barrymulinwqn/ESP32-robot-competition/Arduino/TB6612_D153C_opposite.jpg

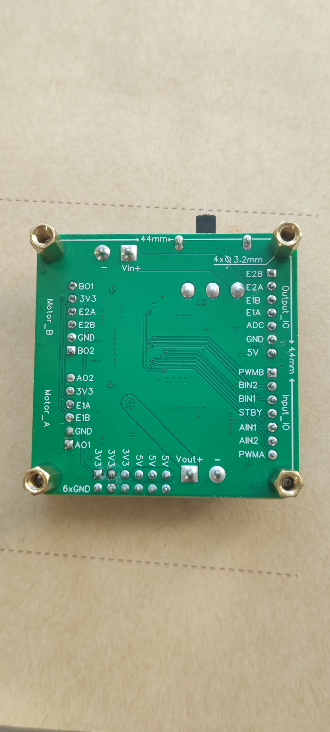
Arduino/TB6612_D153C_opposite.jpg
