barrymulinwqn/ESP32-robot-competition/Arduino/joystick_bluetooth/2M16S_final.jpg

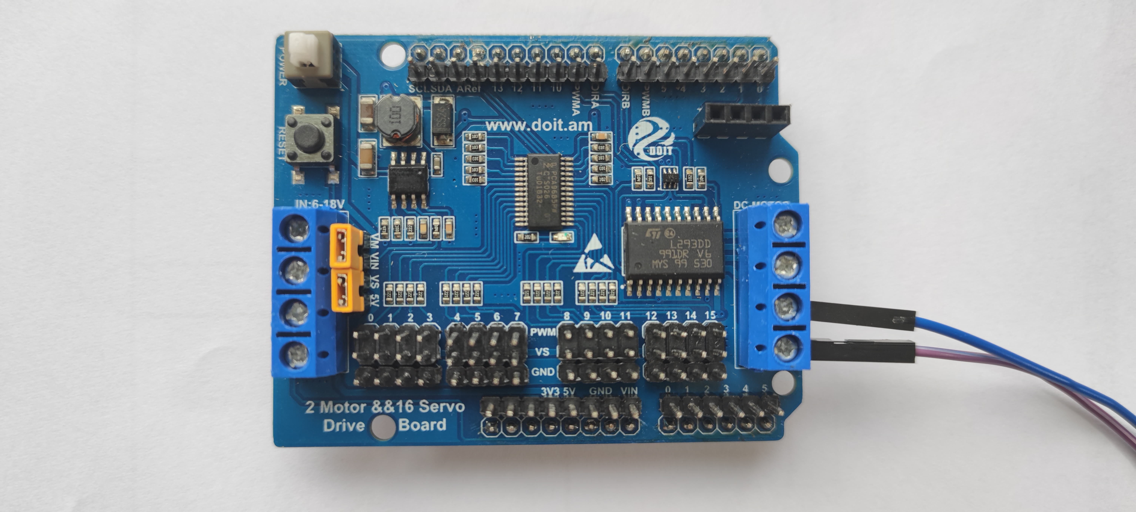
Arduino/joystick_bluetooth/2M16S_final.jpg
