barrymulinwqn/ESP32-robot-competition/README.md

# ESP32-robot-competition
ESP32 Arduino Android
