barrymulinwqn/ESP32-robot-competition/Arduino/硬件接线图.md

# 硬件接线图

## 硬件清单

| 设备 | 型号 | 数量 |
|---|---|---|
| 主控芯片 | ESP32-S3 N8R2 开发板 | 1 |
| 电机驱动模块 | TB6612 D153C 双路驱动稳压模块 | 1 |
| 电池 | 18650 锂离子电池 7.4V 5550mWh | 2节（串联） |
| 直流电机 | 33GB-520-18.7F DC 12V 320RPM | 2 |
| 激光发射器 | 18×45 980nm 30mW 100KHz 5V TTL调制 | 1 |
| 激光接收器 | VS1838B（1838） | 1 |
| 安卓手机 | - | 1 |

---

## 1. 供电电路

> ⚠️ **D153C 与普通 TB6612 裸板不同**：D153C 是**内置降压稳压电路的增强版模块**，
> 自带 ON/OFF 开关，直接将电池电压转换为 5V 和 3.3V 向外输出，无需额外降压模块。

```
18650 电池组（2节串联 标称~7.4V，满电~8.4V）
        │
        ├──[正极]──────────────→ D153C 顶部端子 Vin+（电源输入正极）
        │                               │
        │                    内置 ON/OFF 开关
        │                               │
        │                    D153C 内置降压稳压电路
        │                       ├── 5V 输出 ──→ ESP32-S3 5V 引脚
        │                       ├── 5V 输出 ──→ 激光发射器 VCC
        │                       ├── 3V3 输出 ──→ VS1838B VCC
        │                       └── Vout+ ──→ 电池原始电压直通（备用）
        │
        └──[负极]──────────────→ D153C 顶部端子 -（共地 GND，接所有模块 GND）
```

> **重要说明**
> - 2节 18650 串联标称 7.4V，电机额定 12V，实际转速约为额定的 62%，扭矩按比例降低，仍可正常工作
> - D153C 模块**内置降压电路**，5V 输出直接为 ESP32-S3 供电，**无需另备 LM2596 等独立降压模块**
> - D153C 模块的 5V/3V3 输出已做噪声隔离，电机启动浪涌不会影响 ESP32 供电稳定性
> - D153C 顶部有 **ON/OFF 拨动开关**，整个系统统一断电

---

## 2. ESP32-S3 N8R2 → TB6612 D153C 接线

### TB6612 D153C 模块引脚布局（实物参考）

```
┌─────────────────────────────────────────────────────────┐
│                 D153C 模块正面（俯视）                    │
│                                                         │
│  ┌─────────────┐  [ON/OFF 拨动开关]                      │
│  │  -  │ Vin+ │  ← 顶部 2针螺丝端子（电池输入）          │
│  └─────────────┘                                        │
│                                                         │
│  右侧 Input IO（控制信号输入，来自 ESP32）：             │
│    PWMB BIN2 BIN1 STBY AIN1 AIN2 PWMA                  │
│                                                         │
│  右侧 Output IO（编码器/电源输出）：                     │
│    5V  GND  E1B  E1A  E2A  E2B                          │
│                                                         │
│  左侧 Motor_B 输出（通孔引脚）：                        │
│    BO1  3V3  E2A  E2B  GND  BO2                         │
│                                                         │
│  左侧 Motor_A 输出（通孔引脚）：                        │
│    AO2  3V3  E1A  E1B  GND  AO1                         │
│                                                         │
│  底部排针（左→右）：                                    │
│    6xGND | 3V3 | 3V3 | 5V | 5V | 5V | Vout+            │
│                                                         │
│  ┌───────────┐  ┌───────────┐  ← 右侧白色 JST 4Pin      │
│  │ Motor_B   │  │ Motor_A   │    (电机+编码器接口)       │
│  └───────────┘  └───────────┘                           │
└─────────────────────────────────────────────────────────┘
```

> **引脚分区说明**
> - **顶部端子 Vin+/-**：电池电源唯一输入口，接电池后由内置开关控制通断
> - **Input IO**（右侧下组）：来自 ESP32 的控制信号（PWMA/B、AIN/BIN、STBY）
> - **Output IO**（右侧上组）：5V 和 GND 输出，以及编码器信号引出
> - **底部 3V3/5V**：稳压输出，可为 ESP32 和其他模块供电
> - **编码器引脚 E1A/E1B/E2A/E2B**：若电机带编码器则接入，本项目暂不使用可悬空

### 接线对照表

| D153C 引脚 | 方向 | 连接至 | 说明 |
|:---:|:----:|:---:|---|
| **Vin+**（顶部端子） | ← | 电池正极（~7.4V） | 模块唯一电源正极输入，驱动电机 + 内部稳压 |
| **-**（顶部端子） | ← | 电池负极 / 共地 | 模块唯一电源负极输入 |
| **5V**（底部排针） | → | ESP32-S3 **5V** 引脚 | D153C 向外提供 5V，为 ESP32 供电 |
| **3V3**（底部排针） | → | VS1838B VCC / 激光器备用 | D153C 向外提供 3.3V |
| **GND**（底部 6xGND） | — | ESP32 GND / 所有模块共地 | 接任意一个 GND 针即可 |
| **STBY** | ← | GPIO 10 | 驱动使能（HIGH=工作，LOW=休眠）|
| **PWMA** | ← | GPIO 4 | 左电机（A）PWM 速度控制 |
| **AIN1** | ← | GPIO 5 | 左电机（A）方向控制引脚1 |
| **AIN2** | ← | GPIO 6 | 左电机（A）方向控制引脚2 |
| **PWMB** | ← | GPIO 7 | 右电机（B）PWM 速度控制 |
| **BIN1** | ← | GPIO 8 | 右电机（B）方向控制引脚1 |
| **BIN2** | ← | GPIO 9 | 右电机（B）方向控制引脚2 |

---

## 3. TB6612 D153C → 电机（33GB-520-18.7F）接线

| TB6612 引脚 | 连接至 | 说明 |
|:---:|:---:|---|
| **AO1** | → 左电机 正极线（红） | 电机 A 输出端1 |
| **AO2** | → 左电机 负极线（黑） | 电机 A 输出端2 |
| **BO1** | → 右电机 正极线（红） | 电机 B 输出端1 |
| **BO2** | → 右电机 负极线（黑） | 电机 B 输出端2 |

> 若调试时电机实际转向与预期相反，**互换该电机的两根输出线**即可（例如 AO1/AO2 对调），无需修改代码。

---

## 4. 激光发射器接线（18×45 980nm 30mW TTL调制模组）

### 模块引脚（通常为3线）

| 激光发射器引脚 | 颜色 | 连接至 | ESP32-S3 引脚/电源 | 说明 |
|:---:|:----:|:---:|:---:|---|
| **VCC** | 红 | → | 5V（**D153C 底部 5V 输出**）| 模组工作电压 5V |
| **GND** | 黑 | → | GND | 共地 |
| **TTL / Signal** | 黄/白 | → | GPIO 11 | PWM 调制信号输入 |

> **信号说明**
> - ESP32 GPIO 输出 3.3V，TTL 标准 VIH ≥ 2.0V，**无需电平转换**，可直连
> - GPIO 11 输出 **38 KHz PWM 方波**（占空比 50%）驱动激光以匹配 VS1838B 接收器
> - `HIGH`（PWM 输出）= 激光开启；`LOW`（停止 PWM）= 激光关闭

---

## 5. 激光接收器接线（VS1838B / 1838）

### VS1838B 引脚图（正面引脚朝下，凸面朝向自己）

```
     ┌──────────┐
     │  VS1838B │
     │  (1838)  │
     └──┬──┬──┬─┘
        │  │  │
       (1) (2) (3)
       OUT GND VCC
```

| 1838 引脚 | 编号 | 连接至 | ESP32-S3 引脚/电源 | 说明 |
|:---:|:----:|:---:|:---:|---|
| **OUT** | 引脚1（左）| → | GPIO 12 | 信号输出（Active LOW） |
| **GND** | 引脚2（中）| → | GND | 共地 |
| **VCC** | 引脚3（右）| → | 3.3V（**D153C 底部 3V3 输出**）| 工作电压（2.7~5.5V）|

> **工作原理**
> - VS1838B 内置 **38 KHz 带通滤波器**，激光发射器以 38 KHz 调制时可被正常接收
> - 接收到有效信号时 OUT 输出**低电平**（Active LOW），ESP32 读取 LOW 即表示检测到激光
> - 用于**激光对射**场景：激光束被遮断时，OUT 从 LOW 变为 HIGH，触发 ESP32 中断或轮询检测

---

## 6. ESP32-S3 N8R2 完整 GPIO 分配表

| GPIO 编号 | 方向 | 功能类型 | 连接设备 | 备注 |
|:---:|:----:|:---:|---|---|
| **GPIO 4** | 输出 | LEDC PWM | TB6612 PWMA | 左电机速度（0~255） |
| **GPIO 5** | 输出 | Digital OUT | TB6612 AIN1 | 左电机方向1 |
| **GPIO 6** | 输出 | Digital OUT | TB6612 AIN2 | 左电机方向2 |
| **GPIO 7** | 输出 | LEDC PWM | TB6612 PWMB | 右电机速度（0~255） |
| **GPIO 8** | 输出 | Digital OUT | TB6612 BIN1 | 右电机方向1 |
| **GPIO 9** | 输出 | Digital OUT | TB6612 BIN2 | 右电机方向2 |
| **GPIO 10** | 输出 | Digital OUT | TB6612 STBY | 驱动器使能 |
| **GPIO 11** | 输出 | LEDC PWM | 激光发射器 TTL | 38 KHz 载波 |
| **GPIO 12** | 输入 | Digital IN + 中断 | VS1838B OUT | 激光接收检测 |
| **GPIO 43** | 输出 | UART0 TX | USB 调试串口 | 保留 |
| **GPIO 44** | 输入 | UART0 RX | USB 调试串口 | 保留 |
| **内置 WiFi** | 双向 | 802.11 b/g/n | 安卓手机 | AP 或 STA 模式 |

> **N8R2 禁用 GPIO 说明**
> - GPIO 26~32：8 MB Quad-Flash 内部占用，**绝对禁止**用作 IO（未引出到引脚排针）
> - GPIO 35~37：2 MB PSRAM（R2）内部占用，**绝对禁止**用作 IO（虽然引脚排针上有标注，但内部已被占用）
> - GPIO 19、20：USB OTG D−/D+，调试时避免外接负载
> - GPIO 0：BOOT 按键，避免外部上拉/下拉冲突

---

## 7. 完整接线总览（ASCII 系统图）

```
  ┌─────────────────────────────────────────────────────┐
  │               ESP32-S3 N8R2 开发板                   │
  │                                                     │
  │  GPIO4  ─────────────────────→  D153C PWMA          │
  │  GPIO5  ─────────────────────→  D153C AIN1          │
  │  GPIO6  ─────────────────────→  D153C AIN2          │
  │  GPIO7  ─────────────────────→  D153C PWMB          │
  │  GPIO8  ─────────────────────→  D153C BIN1          │
  │  GPIO9  ─────────────────────→  D153C BIN2          │
  │  GPIO10 ─────────────────────→  D153C STBY          │
  │  GPIO11 ─────────────────────→  激光发射器 TTL       │
  │  GPIO12 ←─────────────────── VS1838B OUT            │
  │  5V     ←──── D153C 5V 输出（D153C 为 ESP32 供电）  │
  │  GND    ──────────────────── 共地（所有模块）        │
  └─────────────────────────────────────────────────────┘
         ↕ WiFi (IEEE 802.11)
    安卓手机 APP

  ┌──────────────────────────────────┐   ┌──────────────────────┐
  │         D153C 模块               │   │  18650×2 电池组      │
  │                                  │   │  串联 ~7.4V           │
  │  [ON/OFF 开关]                   │   │                      │
  │  Vin+ ←──────────────────────────────── 电池正极           │
  │   -   ←──────────────────────────────── 电池负极           │
  │                                  │   └──────────────────────┘
  │  5V 输出  ──→ ESP32-S3 5V        │
  │  5V 输出  ──→ 激光发射器 VCC     │
  │  3V3 输出 ──→ VS1838B VCC        │
  │  6xGND    ──→ 共地汇流点         │
  │                                  │
  │  AO1 ──→ 左电机(+) [红]         │
  │  AO2 ──→ 左电机(-) [黑]         │
  │  BO1 ──→ 右电机(+) [红]         │
  │  BO2 ──→ 右电机(-) [黑]         │
  └──────────────────────────────────┘

  ┌──────────────────────────┐     ┌──────────────────────┐
  │  激光发射器 980nm TTL    │     │  VS1838B 激光接收器  │
  │  VCC → D153C 5V          │     │  VCC → D153C 3V3     │
  │  GND → GND               │     │  GND → GND           │
  │  TTL ← GPIO11 (38KHz)   │     │  OUT → GPIO12        │
  └──────────────────────────┘     └──────────────────────┘
```

---

## 8. 电机运动控制逻辑真值表

> **定义**：电机 A = 左电机，电机 B = 右电机
> **PWM**：255 = 全速，0 = 停止，可设中间值做差速转弯

| 动作 | 左电机（A） | AIN1 | AIN2 | PWMA | 右电机（B） | BIN1 | BIN2 | PWMB |
|:----:|:---:|:----:|:----:|:----:|:---:|:----:|:----:|:----:|
| **前进** | 正转 | HIGH | LOW | 255 | 正转 | HIGH | LOW | 255 |
| **后退** | 反转 | LOW | HIGH | 255 | 反转 | LOW | HIGH | 255 |
| **左前**（左弧线前进）| 停止 | LOW | LOW | 0 | 正转 | HIGH | LOW | 255 |
| **右前**（右弧线前进）| 正转 | HIGH | LOW | 255 | 停止 | LOW | LOW | 0 |
| **左后**（左弧线后退）| 停止 | LOW | LOW | 0 | 反转 | LOW | HIGH | 255 |
| **右后**（右弧线后退）| 反转 | LOW | HIGH | 255 | 停止 | LOW | LOW | 0 |
| **原地左转** | 反转 | LOW | HIGH | 200 | 正转 | HIGH | LOW | 200 |
| **原地右转** | 正转 | HIGH | LOW | 200 | 反转 | LOW | HIGH | 200 |
| **制动停止** | 制动 | HIGH | HIGH | 0 | 制动 | HIGH | HIGH | 0 |
| **滑行停止** | 惰行 | LOW | LOW | 0 | 惰行 | LOW | LOW | 0 |

> **STBY（GPIO 10）**：必须 `HIGH` 电机才能工作；置 `LOW` 可紧急切断双路电机

---

## 9. 安卓手机通信方案（WiFi TCP/WebSocket）

### 推荐方案：ESP32 作为 WiFi AP（比赛环境首选）

```
安卓手机 APP
    │
    └──── WiFi ────→ ESP32-S3（AP 模式）
                      │  SSID: Robot-ESP32
                      │  IP:   192.168.4.1
                      │  Port: 8080（TCP / WebSocket）
                      │
                      ├─── 解析指令 ──→ 控制电机（GPIO 4~10）
                      ├─── 解析指令 ──→ 控制激光（GPIO 11）
                      └─── 读取状态 ←── 激光接收（GPIO 12）
```

### 控制指令格式（JSON over TCP）

```json
{ "cmd": "forward",       "speed": 200 }
{ "cmd": "backward",      "speed": 200 }
{ "cmd": "left_forward",  "speed": 180 }
{ "cmd": "right_forward", "speed": 180 }
{ "cmd": "left_backward", "speed": 180 }
{ "cmd": "right_backward","speed": 180 }
{ "cmd": "spin_left",     "speed": 150 }
{ "cmd": "spin_right",    "speed": 150 }
{ "cmd": "stop" }
{ "cmd": "laser_on" }
{ "cmd": "laser_off" }
```

### 状态上报格式（ESP32 → 安卓）

```json
{ "laser_hit": true,  "timestamp": 12345 }
{ "laser_hit": false, "timestamp": 12389 }
```

---

## 10. 注意事项与安全提醒

| 序号 | 事项 | 说明 |
|:----:|---|---|
| 1 | **必须共地** | 电池组、D153C、ESP32、激光模组的 GND 必须全部短接 |
| 2 | **D153C 内置稳压** | D153C 自带降压电路，5V 输出给 ESP32，3V3 输出给小信号模块，**无需另备 LM2596/MP1584 降压模块** |
| 3 | **滤波电容** | D153C 内部已有滤波电容；如出现电机噪声干扰，可在 ESP32 5V 与 GND 之间额外并联 100µF 电解电容 |
| 4 | **激光安全** | 980nm 30mW 近红外激光对眼睛有害，**严禁直视**激光束 |
| 5 | **电池放电倍率** | 两个 12V 电机在 7.4V 下启动电流可达 2~4A，确认 18650 电池持续放电倍率 ≥ 2C |
| 6 | **N8R2 GPIO 限制** | GPIO 26~32 被 Flash/PSRAM 占用，**禁止**用作普通 IO |
| 7 | **STBY 控制** | 若无需动态控制休眠，可将 STBY 直接接 3.3V 常高，GPIO 10 可释放 |
| 8 | **激光调制频率** | 激光发射器调制频率须设为 **38 KHz** 方可被 VS1838B 正确解调 |

---

## 11. 引脚详细说明（新手必读）

### 11.1 TB6612 D153C — 电源引脚说明（与普通 TB6612 裸板的本质区别）

**D153C 是内置降压稳压电路的增强版模块，电源接线方式与普通 TB6612 裸板完全不同。**

普通 TB6612 裸板有 VM（电机电源输入）和 VCC（逻辑电源输入）两个独立引脚。
D153C 模块则只有一个电源输入口，内部自动生成所需的各路电压。

| 引脚 | 位置 | 方向 | 接线 | 功能说明 |
|:----:|:----:|:----:|:----:|---|
| **Vin+** | 顶部 2针螺丝端子（右侧） | 输入 | 电池正极（~7.4 V） | 模块唯一电源正极，电流从此进入，驱动电机 + 内部稳压器 |
| **-** | 顶部 2针螺丝端子（左侧） | 输入 | 电池负极 / 共地 | 模块唯一电源负极，等同于系统 GND |
| **5V** | 底部排针 / 右侧 Output IO | 输出 | → ESP32-S3 5V 引脚 | 内置降压 IC 输出的稳压 5V，**向外供电** |
| **3V3** | 底部排针 / 左侧 Motor 排针 | 输出 | → VS1838B VCC 等 | 内置 LDO 输出的稳压 3.3V，**向外供电** |
| **Vout+** | 底部排针（最右） | 输出 | 备用（电池电压直通）| 未经稳压的原始电池电压，供其他大功率负载 |

> **记忆要点**：
> - `Vin+` / `-` ← 电池进来（输入）
> - `5V` / `3V3` → 设备出去（输出）
> - **绝对不要**把 ESP32 的 3.3V 接到 D153C 上（D153C 不需要外部逻辑电源，它自己生成）
> - **绝对不要**把 ESP32 的 5V 接到 D153C 上当输入（应该反过来：D153C 的 5V 输出接 ESP32 的 5V 输入）

---

### 11.2 TB6612 D153C — GND 引脚说明

D153C 模块共有 **多个 GND 引脚**，PCB 内部全部连通（等电位），均可接线：

| GND 位置 | 数量 | 推荐用途 |
|:---:|:----:|---|
| **顶部端子 `-`** | 1 | **主电源地**，接电池负极，是整个系统的 GND 汇流点 |
| **底部排针 6xGND** | 6 | 供其他模块引出接地（接 ESP32 GND、激光模组 GND 等） |
| **左侧 Motor_A 排针 GND** | 1 | 靠近 Motor A 输出排针，可用于电机端布线接地 |
| **左侧 Motor_B 排针 GND** | 1 | 靠近 Motor B 输出排针，可用于电机端布线接地 |
| **右侧 Output IO GND** | 1 | 靠近编码器/信号输出排针 |

> **接线建议**：
> 1. 顶部端子 `-` 接电池负极（必须）
> 2. 从底部 6xGND 中取 1~2 根引出，接 ESP32 GND 和激光模组 GND
> 3. 所有 GND 最终汇到电池负极（一点接地，避免地环路）

---

### 11.3 ESP32-S3 N8R2 — 完整引脚布局（实物图对照）

> **方向说明**：USB-C 接口在板子**底部**，ESP32-S3-N8R2 模组芯片在**顶部**。
> 以下排列均从**顶部往底部**数。

```
┌──── 顶部（ESP32模组端）────────────────────── 顶部（ESP32模组端）────┐
│  左侧 J1（从上往下）                   右侧 J3（从上往下）          │
│                                                                     │
│   1  3V3  ◄── 3V3输出①               1  GND  ◄── GND③            │
│   2  3V3  ◄── 3V3输出②               2  TX   (GPIO43, UART0 TX)   │
│   3  RST  (复位)                       3  RX   (GPIO44, UART0 RX)   │
│   4  4    (GPIO4)  → D153C PWMA        4  1    (GPIO1)              │
│   5  5    (GPIO5)  → D153C AIN1        5  2    (GPIO2)              │
│   6  6    (GPIO6)  → D153C AIN2        6  42   (GPIO42)             │
│   7  7    (GPIO7)  → D153C PWMB        7  41   (GPIO41)             │
│   8  15   (GPIO15)                     8  40   (GPIO40)             │
│   9  16   (GPIO16)                     9  39   (GPIO39)             │
│  10  17   (GPIO17)                    10  38   (GPIO38)             │
│  11  18   (GPIO18)                    11  37   (GPIO37) ⛔ PSRAM    │
│  12  8    (GPIO8)  → D153C BIN1       12  36   (GPIO36) ⛔ PSRAM    │
│  13  3    (GPIO3)                     13  35   (GPIO35) ⛔ PSRAM    │
│  14  46   (GPIO46)                    14  0    (GPIO0 / BOOT)       │
│  15  9    (GPIO9)  → D153C BIN2       15  45   (GPIO45)             │
│  16  10   (GPIO10) → D153C STBY       16  48   (GPIO48)             │
│  17  11   (GPIO11) → 激光TTL          17  47   (GPIO47)             │
│  18  12   (GPIO12) ← VS1838B OUT      18  21   (GPIO21)             │
│  19  13   (GPIO13)                    19  20   (GPIO20) ⚠ USB OTG  │
│  20  5V   ◄── 5V输入（接D153C 5V输出）20  GND  ◄── GND④            │
│  21  GND  ◄── GND①                   21  GND  ◄── GND⑤            │
│  22  GND  ◄── GND②                                                 │
└──── 底部（USB-C 端）──────────────────────── 底部（USB-C 端）─────────┘
```

### 3.3V 引脚说明（共两个，均在左侧顶部）

| 3.3V 引脚 | 物理位置 | 本项目用途 | 说明 |
|:---:|:---:|---|---|
| **3V3①** | J1 第 **1** 脚（最顶部第 1 针，远离 USB 端） | 备用扩展 | ESP32 自身 LDO 输出，VS1838B / 激光器已由 D153C 供 3V3，此脚可空置 |
| **3V3②** | J1 第 **2** 脚（最顶部第 2 针，与 3V3① 相邻） | 备用扩展 | 同上，两脚完全等效 |

> ⚠️ **勘误**：旧版本中曾错误描述为"第1脚是GND，第2脚是3V3，第13脚是第二个3V3"。
> 实物图片确认：**第1、2脚均为3V3**，第13脚是 **GPIO3**（非3V3），板子顶部无GND引脚。

---

### 11.4 ESP32-S3 N8R2 — GND 引脚说明（共5个）

开发板引脚排针上共有 **5 个 GND 引脚**，内部全部直连：

```
左侧排针（J1）底部：
│ 21  GND  ◄─── GND①（左侧底部，倒数第2脚，靠近USB-C端）
│ 22  GND  ◄─── GND②（左侧底部，最末脚，最靠USB-C端）

右侧排针（J3）：
│  1  GND  ◄─── GND③（右侧顶部，最顶脚，远离USB-C端，与TX相邻）
│ ...
│ 20  GND  ◄─── GND④（右侧底部，倒数第2脚，靠近USB-C端）
│ 21  GND  ◄─── GND⑤（右侧底部，最末脚，最靠USB-C端）
```

> ⚠️ **勘误**：旧版本错误描述为"左侧第1脚（顶部）是GND"。
> 实物图片确认：**左侧顶部第1、2脚均为3V3**，GND 在左侧**底部**（第21、22脚）。

| GND 编号 | 物理位置 | 本项目接线建议 |
|:---:|:---:|---|
| **GND①②** | 左侧底部（J1 第21、22脚，靠 USB-C 端） | 任选一根接 ESP32 信号模块（VS1838B、激光发射器）的地 |
| **GND③** | 右侧顶部（J3 第1脚，远离 USB-C 端，与TX相邻） | 推荐接公共汇流地（连到 D153C GND 和电池负极汇接点） |
| **GND④⑤** | 右侧底部（J3 第20、21脚，靠 USB-C 端） | 备用，可按布线需要使用 |

> **接线原则**：所有模块的 GND 必须汇到同一节点，避免地线环路引入电机噪声。

---

### 11.5 ESP32-S3 GPIO 编号与板子标注的对应关系

**结论：板子上标注的数字 = GPIO 编号**，两者完全一致。

以 GPIO 10 为例：

| 属性 | 内容 |
|---|---|
| 板子丝印标注 | `10` |
| Arduino 代码中的引脚号 | `10`（即 `pinMode(10, OUTPUT)` 或 `digitalWrite(10, HIGH)`）|
| ESP-IDF 代码中的引脚号 | `GPIO_NUM_10` |
| 物理位置 | 左侧排针（J1）从上往下第 **16** 脚（3V3①, 3V3②, RST, 4, 5, 6, 7, 15, 16, 17, 18, 8, 3, 46, 9, **10**）|

**通用对应规则：**

```
板子丝印数字 N  ←→  GPIO N  ←→  Arduino pinMode(N, ...)
```

> **特殊引脚例外**（非数字标注）：
> | 板子标注 | 对应含义 |
> |:--------:|---------|
> | `3V3` | 3.3 V 电源，非 GPIO |
> | `5V` | 5 V 电源（来自 USB），非 GPIO |
> | `GND` | 地，非 GPIO |
> | `RST` / `EN` | 复位引脚，非普通 GPIO |
> | `BOOT` / `0` | GPIO 0（同时是 BOOT 模式选择，上拉/下拉需谨慎）|
> | `RX` / `44` | GPIO 44（UART0 RX），可复用为普通 GPIO |
> | `TX` / `43` | GPIO 43（UART0 TX），可复用为普通 GPIO |

**N8R2 禁止使用的 GPIO（不在板子引脚上）：**

| GPIO 范围 | 原因 |
|:---:|---|
| GPIO 26 ～ 32 | 被 8 MB Quad-Flash 内部占用，**绝对禁止**用作 IO |
| GPIO 35 ～ 37 | 被 2 MB PSRAM（R2 指 2 MB PSRAM）内部占用，**绝对禁止**用作 IO |
| GPIO 19、20 | USB OTG D−/D+，调试时避免外接负载 |

> **GPIO 10 在 N8R2 上可正常使用**，不属于任何保留范围，用于驱动 TB6612 STBY 完全安全。
