barrymulinwqn/ESP32-robot-competition/Arduino/joystick_bluetooth/ESP32/esp32_decoder.md

# YFRobot 2015 解码器 → ESP32-S3 N8R2 → TB6612 D153C 接线与左摇杆控制说明

## 目录

- [一、系统架构总览](#一系统架构总览)
- [二、硬件清单](#二硬件清单)
- [三、供电电路](#三供电电路)
- [四、YFRobot 2015 解码器接口说明](#四yfrobot-2015-解码器接口说明)
- [五、YFRobot 2015 → ESP32-S3 接线](#五yfrobot-2015--esp32-s3-接线)
- [六、ESP32-S3 → TB6612 D153C 接线](#六esp32-s3--tb6612-d153c-接线)
- [七、TB6612 D153C → 电机接线](#七tb6612-d153c--电机接线)
- [七-2、激光发射器 / VS1838B / WS2812B 接线](#七-2激光发射器--vs1838b--ws2812b-接线)
- [八、GPIO 分配汇总表](#八gpio-分配汇总表)
- [九、完整接线图（ASCII 系统图）](#九完整接线图ascii-系统图)
- [十、左摇杆控制逻辑](#十左摇杆控制逻辑)
- [十一、电机控制真值表](#十一电机控制真值表)
- [十二、注意事项](#十二注意事项)
- [十三、固件烧录说明（Arduino IDE）](#十三固件烧录说明arduino-ide)

---

## 一、系统架构总览

```
蓝牙游戏手柄（普通 BT 手柄）
        │ 无线蓝牙
        ▼
┌─────────────────────────────────────┐
│  YFRobot 2015 游戏手柄解码器        │
│  · 将蓝牙信号还原为 PS2 协议        │
│  · 引脚：GND / VCC / CLK / CS /     │
│          CMD / DAT                  │
└──────┬──────────────────────────────┘
       │ PS2 协议（CLK/CS/CMD/DAT，3.3V TTL）
       ▼
┌───────────────────────────────────────────────────────┐
│                ESP32-S3 N8R2 开发板                    │
│  · 软件 SPI 读取 PS2 手柄状态（左摇杆 LX/LY）         │
│  · 解析摇杆坐标，映射为运动指令                        │
│  · 输出 PWM + 方向信号驱动 TB6612 D153C                │
└──────────────────────┬────────────────────────────────┘
                       │ PWMA/AIN1/AIN2/PWMB/BIN1/BIN2/STBY
                       ▼
┌───────────────────────────────────────────────────────┐
│              TB6612 D153C 双路电机驱动模块              │
│  · 内置降压稳压（Vin: 7.4V → 5V/3.3V 输出）           │
│  · 双 H 桥驱动，单路 1.2A 连续 / 3.2A 峰值            │
└───────────────┬────────────────────┬──────────────────┘
                │ Motor A             │ Motor B
                ▼                     ▼
        左电机（AO1/AO2）      右电机（BO1/BO2）
        33GB-520-18.7F         33GB-520-18.7F
        DC 12V 320RPM          DC 12V 320RPM
```

---

## 二、硬件清单

| 设备 | 型号 | 数量 |
|---|---|---|
| 主控芯片 | ESP32-S3 N8R2 开发板 | 1 |
| 手柄解码器 | YFRobot 2015 游戏手柄解码器 | 1 |
| 电机驱动模块 | TB6612 D153C 双路驱动稳压模块 | 1 |
| 直流减速电机 | 33GB-520-18.7F DC 12V 320RPM | 2 |
| 电池组 | 18650 锂离子电池 7.4V（2节串联） | 1组 |
| 蓝牙游戏手柄 | 普通 BT 手柄（PS2 兼容） | 1 |
| 激光发射器 | 18×45 980nm 30mW 100kHz 5V TTL 调制 | 1 |
| 激光接收器 | VS1838B（1838）红外接收传感器，38 kHz | 1 |
| 可编程 LED 灯条 | WS2812B 5V GRB，10 颗 | 1 条 |
| 上拉电阻 | 10kΩ（1/4W，用于 PS2 DAT 线） | 1 |

---

## 三、供电电路

> ⚠️ **D153C 内置降压稳压电路**，直接将电池电压转换为 5V 和 3.3V 向外输出，无需额外降压模块。

```
18650 电池组（2节串联 标称 ~7.4V，满电 ~8.4V）
        │
        ├──[正极]──[D153C ON/OFF 拨动开关]──→ D153C 顶部端子 Vin+
        │                                           │
        │                               D153C 内置降压稳压电路
        │                                ├── 5V 输出  ──→ ESP32-S3 5V 引脚
        │                                ├── 5V 输出  ──→ 激光发射器 VCC
        │                                ├── 5V 输出  ──→ WS2812B 灯条 5V
        │                                ├── 3.3V 输出 ──→ YFRobot 2015 VCC（⚠️ 见注）
        │                                ├── 3.3V 输出 ──→ VS1838B VCC
        │                                └── Vout+    ──→ 电池原始电压直通（备用）
        │
        └──[负极]──────────────────────→ D153C 顶部端子 -（共地 GND）

GND 汇流点：D153C Vin- = ESP32 GND = YFRobot 2015 GND = 电机地（全部短接）
```

> ⚠️ **电平兼容说明**：
> - ESP32-S3 GPIO 为 3.3V 逻辑，**不耐 5V**
> - YFRobot 2015 解码器如以 **5V 供电**，其 DAT 输出将为 5V 电平，可能损坏 ESP32-S3 GPIO
> - **推荐做法：将 YFRobot 2015 接 D153C 的 3.3V 输出（而非 5V）**，但必须确认解码器能在 3.3V 下稳定启动；若不能，DAT 必须经电平转换后再接 ESP32-S3

> ⚠️ D153C 5V 输出必须有足够的峰值电流裕量，同时供电给 ESP32-S3、WS2812B 和激光发射器。应在这些负载工作、电机启动时测量 5V 母线，确认没有明显掉压；所有模块必须共地。

---

## 四、YFRobot 2015 解码器接口说明

```
┌─────────────────────────────────────────────────────────┐
│               YFRobot 2015 游戏手柄解码器                │
│                                                         │
│   ● GND  —— 电源地                                      │
│   ● VCC  —— 电源输入（接 3.3V，保持与 ESP32 同逻辑电平）│
│   ● CLK  —— PS2 时钟输入（由主机 ESP32 提供）           │
│   ● CS   —— 片选/注意信号（Active LOW，由主机拉低发起）  │
│   ● CMD  —— 命令数据线（主机→解码器，SPI MOSI）         │
│   ● DAT  —— 数据返回线（解码器→主机，SPI MISO）         │
│              （DAT 线需 10kΩ 上拉至 VCC）               │
│                                                         │
│   内部包含：蓝牙接收模块 + PS2 协议转换芯片             │
│   通信协议：PS2 SPI-like，约 50kHz，LSB-first            │
└─────────────────────────────────────────────────────────┘
```

### 引脚功能说明

| 引脚 | 方向（相对ESP32） | 功能 | 电平 |
|:----:|:---:|---|:----:|
| **VCC** | ESP32 → 解码器 | 电源输入 | **3.3V**（推荐，保持电平兼容） |
| **GND** | 共地 | 电源地 | 0V |
| **CLK** | ESP32 → 解码器 | PS2 时钟，通信时钟源由主机生成 | 3.3V |
| **CS** | ESP32 → 解码器 | 片选（Active LOW），低电平激活通信 | 3.3V |
| **CMD** | ESP32 → 解码器 | 命令/数据（MOSI 方向），主机发给解码器 | 3.3V |
| **DAT** | 解码器 → ESP32 | 数据返回（MISO 方向），解码器发给主机 | 3.3V（需10kΩ上拉到VCC） |

---

## 五、YFRobot 2015 → ESP32-S3 接线

### 接线对照表

| YFRobot 2015 引脚 | 方向 | ESP32-S3 N8R2 引脚 | 说明 |
|:---:|:----:|:---:|---|
| **GND** | — | **GND**（任意 GND 针） | 共地，必须连接 |
| **VCC** | ← | **D153C 3.3V 输出** | ⚠️ 接 3.3V（不接 5V），保持信号电平兼容 |
| **CLK** | ← | **GPIO 16** | PS2 时钟，ESP32 输出 |
| **CS** | ← | **GPIO 15** | 片选，ESP32 输出（Active LOW） |
| **CMD** | ← | **GPIO 17** | 命令线，ESP32 输出 |
| **DAT** | → | **GPIO 18** | 数据返回，解码器输出；**DAT ↔ VCC 间接 10kΩ 上拉电阻** |

### 接线示意图

```
YFRobot 2015 解码器                    ESP32-S3 N8R2
┌──────────────┐                    ┌──────────────────┐
│              │                    │                  │
│  GND ────────────────────────────── GND（任意GND针）│
│  VCC ◄───────────────────────────── D153C 3.3V输出  │
│              │                    │                  │
│  CS  ◄─────────── GPIO 15 ──────── (J1 Pin8, 左侧)  │
│  CLK ◄─────────── GPIO 16 ──────── (J1 Pin9, 左侧)  │
│  CMD ◄─────────── GPIO 17 ──────── (J1 Pin10, 左侧) │
│  DAT ──────────── GPIO 18 ──────── (J1 Pin11, 左侧) │
│        ↑                           │                  │
└──────────────┘       DAT↔VCC 之间  └──────────────────┘
               接 10kΩ 上拉电阻（DAT 线接电阻一端，VCC 接电阻另一端）
```

---

## 六、ESP32-S3 → TB6612 D153C 接线

> 详细参考 [`硬件接线图.md`](../../硬件接线图.md) 第 2 节

### 接线对照表

| D153C 引脚 | 方向 | ESP32-S3 GPIO | 说明 |
|:---:|:----:|:---:|---|
| **Vin+**（顶部螺丝端子） | ← | 电池正极（~7.4V） | 唯一电源输入正极 |
| **-**（顶部螺丝端子） | ← | 电池负极 / 共地 | 唯一电源输入负极 |
| **5V**（底部排针） | → | ESP32-S3 **5V** 引脚 | D153C 向外供 5V，为 ESP32 供电 |
| **3.3V**（底部排针） | → | YFRobot 2015 **VCC** | D153C 向外供 3.3V，为解码器供电 |
| **GND**（底部 6xGND） | — | ESP32 GND / 所有模块共地 | |
| **STBY** | ← | **GPIO 10** | 驱动使能（HIGH = 工作，LOW = 休眠） |
| **PWMA** | ← | **GPIO 4** | 左电机（A）PWM 速度控制 |
| **AIN1** | ← | **GPIO 5** | 左电机（A）方向控制引脚 1 |
| **AIN2** | ← | **GPIO 6** | 左电机（A）方向控制引脚 2 |
| **PWMB** | ← | **GPIO 7** | 右电机（B）PWM 速度控制 |
| **BIN1** | ← | **GPIO 8** | 右电机（B）方向控制引脚 1 |
| **BIN2** | ← | **GPIO 9** | 右电机（B）方向控制引脚 2 |

---

## 七、TB6612 D153C → 电机接线

| TB6612 引脚 | 方向 | 连接至 | 说明 |
|:---:|:----:|:---:|---|
| **AO1** | → | 左电机 正极线（红） | 电机 A 输出端 1 |
| **AO2** | → | 左电机 负极线（黑） | 电机 A 输出端 2 |
| **BO1** | → | 右电机 正极线（红） | 电机 B 输出端 1 |
| **BO2** | → | 右电机 负极线（黑） | 电机 B 输出端 2 |

> 若调试时电机实际转向与预期相反，**互换该电机的两根输出线**（如 AO1↔AO2 对调），无需修改代码。

---

## 七-2、激光发射器 / VS1838B / WS2812B 接线

### 激光发射器接线

> 固件使用 IRremote 发送 38 kHz NEC 载波突发。激光发射器清单标注为 100 kHz TTL，必须先核对其 TTL 输入是“最大调制带宽”还是“固定 100 kHz 载波要求”；若只能接受固定 100 kHz，当前方案不能直接使用。

| 激光发射器引脚 | 方向 | 连接至 | 说明 |
|:---:|:----:|:---:|---|
| **VCC** | ← | D153C **5V** 输出 | 5V 供电 |
| **GND** | — | 公共 **GND** | 共地 |
| **TTL** | ← | ESP32 **GPIO 11** | IRremote 生成 38 kHz NEC 载波突发；需确认发射器 TTL 输入兼容 38 kHz |

### VS1838B 激光接收器接线

> VS1838B 内置 38 kHz 带通滤波器和解调电路，OUT 引脚正常为高电平，接收到匹配信号时拉低。

| VS1838B 引脚 | 方向 | 连接至 | 说明 |
|:---:|:----:|:---:|---|
| **VCC** | ← | D153C **3.3V** 输出 | 3.3V 供电（与 ESP32 GPIO 电平兼容） |
| **GND** | — | 公共 **GND** | 共地 |
| **OUT** | → | ESP32 **GPIO 12** | Active LOW，代码配置 INPUT_PULLUP |

```
VS1838B 封装引脚（正面朝向自己，凸面朝上）：
    ┌─────────┐
    │         │
    │         │
    └──┬──┬──┘      OUT  GND  VCC
          ↓    ↓    ↓
          1    2    3
  （从左到右：1=OUT，2=GND，3=VCC）
```

### WS2812B 可编程 LED 灯条接线

> WS2812B 每颜 LED 内置控制 IC，通过单线串行协议（800kHz）控制 RGB 颜色。**初始化全部绿色，命中一次就有一颜 LED 变红，R2 键重置为绿色。**

| WS2812B 引脚 | 方向 | 连接至 | 说明 |
|:---:|:----:|:---:|---|
| **5V** | ← | D153C **5V** 输出 | 5V 供电（⚠️ 每颗全亮白色约 60mA，10 颗不超过 600mA） |
| **GND** | — | 公共 **GND** | 共地 |
| **DIN** | ← | ESP32 **GPIO 13** | FastLED 数据线（GRB 色序） |

> ⚠️ **功耗提示**：代码中亮度设为 60（约23%），10 颗实际峰值电流约 140mA；仍须确认 D153C 5V 输出有足够电流余量。

---

## 八、GPIO 分配汇总表

| GPIO 编号 | 方向 | 功能类型 | 连接设备 | 备注 |
|:---:|:----:|:---:|:---:|---|
| **GPIO 4** | 输出 | LEDC PWM | TB6612 **PWMA** | 左电机速度（0~255） |
| **GPIO 5** | 输出 | Digital OUT | TB6612 **AIN1** | 左电机方向1 |
| **GPIO 6** | 输出 | Digital OUT | TB6612 **AIN2** | 左电机方向2 |
| **GPIO 7** | 输出 | LEDC PWM | TB6612 **PWMB** | 右电机速度（0~255） |
| **GPIO 8** | 输出 | Digital OUT | TB6612 **BIN1** | 右电机方向1 |
| **GPIO 9** | 输出 | Digital OUT | TB6612 **BIN2** | 右电机方向2 |
| **GPIO 10** | 输出 | Digital OUT | TB6612 **STBY** | 驱动器使能 |
| **GPIO 11** | 输出 | IRremote 定时器 | 激光发射器 **TTL** | 38 kHz NEC 载波突发 |
| **GPIO 12** | 输入 | Digital IN | VS1838B **OUT** | Active LOW，INPUT_PULLUP，接收激光命中 |
| **GPIO 13** | 输出 | Digital OUT | WS2812B **DIN** | FastLED GRB 数据线 |
| **GPIO 15** | 输出 | Digital OUT | YFRobot 2015 **CS** | PS2 片选（Active LOW） |
| **GPIO 16** | 输出 | Digital OUT | YFRobot 2015 **CLK** | PS2 时钟 |
| **GPIO 17** | 输出 | Digital OUT | YFRobot 2015 **CMD** | PS2 命令（MOSI） |
| **GPIO 18** | 输入 | Digital IN | YFRobot 2015 **DAT** | PS2 数据返回（MISO），需10kΩ上拉 |
| **GPIO 43** | 输出 | UART0 TX | USB 调试串口 | 保留 |
| **GPIO 44** | 输入 | UART0 RX | USB 调试串口 | 保留 |

### ESP32-S3 N8R2 物理引脚位置（左侧 J1，从上往下）

```
┌──── 顶部（ESP32模组端）────────────────────────────────────┐
│  左侧 J1（从上往下）           右侧 J3（从上往下）         │
│                                                            │
│   1  3V3  (备用)                1  GND                    │
│   2  3V3  (备用)                2  TX  (GPIO43)            │
│   3  RST  (复位)                3  RX  (GPIO44)            │
│   4  4    → D153C PWMA          ...                       │
│   5  5    → D153C AIN1                                    │
│   6  6    → D153C AIN2                                    │
│   7  7    → D153C PWMB                                    │
│   8  15   → YFRobot CS      ← 新增：PS2 片选              │
│   9  16   → YFRobot CLK     ← 新增：PS2 时钟              │
│  10  17   → YFRobot CMD     ← 新增：PS2 命令              │
│  11  18   ← YFRobot DAT     ← 新增：PS2 数据返回          │
│  12  8    → D153C BIN1                                    │
│  13  3    (空闲)                                          │
│  14  46   (空闲)                                          │
│  15  9    → D153C BIN2                                    │
│  16  10   → D153C STBY                                    │
│  17  11   → 激光发射器 TTL（38kHz NEC 载波突发）      │
│  18  12   ← VS1838B OUT（INPUT_PULLUP，Active LOW）    │
│  19  13   → WS2812B DIN（FastLED 数据线）             │
│  20  5V   ← D153C 5V输出（ESP32供电）                     │
│  21  GND                                                  │
│  22  GND                                                  │
└──── 底部（USB-C 端）──────────────────────────────────────┘
```

---

## 九、完整接线图（ASCII 系统图）

```
  ┌──────────────────────────────────────────────────────────────────┐
  │              18650 电池组（2节串联，~7.4V）                       │
  └────────────────────────┬─────────────────────────────────────────┘
                           │ [D153C ON/OFF 拨动开关]
                           ▼ Vin+（~7.4V）
  ┌────────────────────────────────────────────────────────────────┐
  │                   TB6612 D153C 电机驱动模块                     │
  │  ┌─── 电源 ───────────────────────────────────────────────┐    │
  │  │  Vin+ ←──── 电池组正极（经ON/OFF开关）                  │    │
  │  │  -    ←──── 公共 GND 汇流点                             │    │
  │  │  5V   ────► ESP32-S3 5V（为ESP32供电）                  │    │
  │  │  3.3V ────► YFRobot 2015 VCC（⚠️ 接3.3V，非5V）        │    │
  │  │  GND  ────► 公共 GND 汇流点                             │    │
  │  └─────────────────────────────────────────────────────────┘    │
  │  ┌─── 控制信号输入（来自 ESP32）───────────────────────────┐    │
  │  │  STBY ◄──── GPIO 10                                    │    │
  │  │  PWMA ◄──── GPIO 4 （LEDC PWM）                        │    │
  │  │  AIN1 ◄──── GPIO 5                                     │    │
  │  │  AIN2 ◄──── GPIO 6                                     │    │
  │  │  PWMB ◄──── GPIO 7 （LEDC PWM）                        │    │
  │  │  BIN1 ◄──── GPIO 8                                     │    │
  │  │  BIN2 ◄──── GPIO 9                                     │    │
  │  └─────────────────────────────────────────────────────────┘    │
  │  ┌─── 电机输出 ─────────────────────────────────────────────┐   │
  │  │  AO1 ──────────────────────────────► 左电机 正极（红）   │   │
  │  │  AO2 ──────────────────────────────► 左电机 负极（黑）   │   │
  │  │  BO1 ──────────────────────────────► 右电机 正极（红）   │   │
  │  │  BO2 ──────────────────────────────► 右电机 负极（黑）   │   │
  │  └─────────────────────────────────────────────────────────┘    │
  └────────────────────────────────────────────────────────────────┘

  ┌────────────────────────────────────────────────────────────────┐
  │                    ESP32-S3 N8R2 开发板                         │
  │                                                                 │
  │  ← D153C 5V ──── 5V（ESP32供电输入）                           │
  │  ─ GND ─── 公共GND                                             │
  │                                                                 │
  │  ┌─── PS2 接口（软件SPI，读取手柄摇杆数据）──────────────┐     │
  │  │  GPIO 15 ──────────────────────────────► YFRobot CS   │     │
  │  │  GPIO 16 ──────────────────────────────► YFRobot CLK  │     │
  │  │  GPIO 17 ──────────────────────────────► YFRobot CMD  │     │
  │  │  GPIO 18 ◄──────────────────────────── YFRobot DAT    │     │
  │  │                    (DAT ↔ VCC 间接 10kΩ 上拉电阻)      │     │
  │  └────────────────────────────────────────────────────────┘     │
  │                                                                 │
  │  ┌─── TB6612 D153C 控制输出 ─────────────────────────────┐     │
  │  │  GPIO 10 ──────────────────────────────► D153C STBY   │     │
  │  │  GPIO  4 ──────────────────────────────► D153C PWMA   │     │
  │  │  GPIO  5 ──────────────────────────────► D153C AIN1   │     │
  │  │  GPIO  6 ──────────────────────────────► D153C AIN2   │     │
  │  │  GPIO  7 ──────────────────────────────► D153C PWMB   │     │
  │  │  GPIO  8 ──────────────────────────────► D153C BIN1   │     │
  │  │  GPIO  9 ──────────────────────────────► D153C BIN2   │     │
  │  └────────────────────────────────────────────────────────┘     │
  └────────────────────────────────────────────────────────────────┘

  ┌────────────────────────────────────────────────────────────────┐
  │                  YFRobot 2015 游戏手柄解码器                    │
  │                                                                 │
  │  GND ──────────────────────────────────────► 公共 GND          │
  │  VCC ◄──────────────────────────────────── D153C 3.3V 输出     │
  │  CS  ◄──────────────────────────────────── ESP32 GPIO 15       │
  │  CLK ◄──────────────────────────────────── ESP32 GPIO 16       │
  │  CMD ◄──────────────────────────────────── ESP32 GPIO 17       │
  │  DAT ──────────────────────────────────────► ESP32 GPIO 18     │
  │                                             [10kΩ 上拉至VCC]   │
  │                                                                 │
  │         ↑ 蓝牙接收                                             │
  │  ┌──────────────────┐                                          │
  │  │ 蓝牙游戏手柄      │ ← 配对，左摇杆提供 LX（0~255）/ LY（0~255）│
  │  └──────────────────┘                                          │
  └────────────────────────────────────────────────────────────────┘

  左电机（33GB-520-18.7F）              右电机（33GB-520-18.7F）
  DC 12V 320RPM                        DC 12V 320RPM
  正极（红）← D153C AO1                正极（红）← D153C BO1
  负极（黑）← D153C AO2                负极（黑）← D153C BO2

  ┌────────────────────────────────────────────────────────────────┐
  │                  激光 / 接收 / LED 模块                    │
  │                                                                 │
  │  激光发射器（18×45 980nm 30mW，5V TTL）                       │
  │    VCC ◄──── D153C 5V 输出                                   │
  │    GND ────► 公共 GND                                        │
        │    TTL ◄──── ESP32 GPIO 11（38kHz NEC 载波突发）           │
  │                                                                 │
  │  VS1838B 激光接收器（38kHz 解调）                              │
  │    VCC ◄──── D153C 3.3V 输出                                 │
  │    GND ────► 公共 GND                                        │
  │    OUT ────► ESP32 GPIO 12（INPUT_PULLUP，Active LOW）        │
  │                                                                 │
      │  WS2812B 可编程 LED 灯条（10 颗，GRB）                         │
  │    5V  ◄──── D153C 5V 输出                                   │
  │    GND ────► 公共 GND                                        │
  │    DIN ◄──── ESP32 GPIO 13（FastLED 单线协议）              │
  │                                                                 │
  │  控制逻辑：                                                    │
        │    L2 短按 → 发送 1 帧 NEC 激光数据                          │
  │    L2 长按 → 每 300ms 自动循环发射                         │
  │    R2 按下 → WS2812B 全部恢复绿色（重置命中计数）           │
  └────────────────────────────────────────────────────────────────┘
```

---

## 十、左摇杆控制逻辑

> 左摇杆控制运动方向；L2 键控制激光发射；R2 键重置 LED 灯条。

### 10.1 PS2 摇杆轴坐标系

| 轴 | PS2 通道 | 最小值 | 中心值 | 最大值 | 说明 |
|:--:|:---:|:---:|:---:|:---:|---|
| LX | 左摇杆X轴 | 0 | 128 | 255 | 0 = 最左，255 = 最右 |
| LY | 左摇杆Y轴 | 0 | 128 | 255 | 0 = 最上（前推），255 = 最下（后拉） |

### 10.2 摇杆区域划分（死区 + 8方向）

```
         LX轴（左→右）
         0          96   128   160          255
         ├───────────┼────┼─────┼────────────┤
    0    │  左后区域  │    前进   │  右后区域  │  ← LY = 0（最前推）
         │           │           │           │
   96    ├───────────┼────┼─────┼────────────┤
         │  原地左转  │  死区停止  │  原地右转  │
  128    │           │  （中心）  │           │ LY轴
  160    ├───────────┼────┼─────┼────────────┤  （上→下）
         │  左后区域  │    后退   │  右后区域  │
  255    │           │           │           │  ← LY = 255（最后拉）
         └───────────┴────┴─────┴────────────┘
```

### 10.3 动作判定规则

| 优先级 | 条件 | 动作 |
|:---:|---|---|
| 1 | LX ∈ [96, 160] 且 LY ∈ [96, 160] | **滑行停止**（双轴在死区） |
| 2 | LY < 96 且 LX ∈ [96, 160] | **前进**（前推，无转向） |
| 3 | LY > 160 且 LX ∈ [96, 160] | **后退**（后拉，无转向） |
| 4 | LX < 96 且 LY ∈ [96, 160] | **原地左转**（纯左，无前后） |
| 5 | LX > 160 且 LY ∈ [96, 160] | **原地右转**（纯右，无前后） |
| 6 | LY < 96 且 LX < 96 | **左前**（左弧线前进） |
| 7 | LY < 96 且 LX > 160 | **右前**（右弧线前进） |
| 8 | LY > 160 且 LX < 96 | **左后**（左弧线后退） |
| 9 | LY > 160 且 LX > 160 | **右后**（右弧线后退） |

> **死区说明**：中心区域 LX/LY ∈ [96, 160]（±32 死区）防止摇杆回弹误触发，实际死区大小可在代码中调整。
### 10.4 按键控制（L2 / R2）

| 按键 | 操作 | 功能 | 说明 |
|:----:|---|---|---|
| **L2** | 短按（按下 < 500ms 后松开） | **发送一帧 NEC 激光数据** | 38 kHz 载波触发 VS1838B |
| **L2** | 长按（持续 ≥ 500ms） | **循环发送 NEC 帧**（每 300ms 一次） | 每帧之间保留 100ms 冷却 |
| **R2** | 按下（边沿触发） | **重置 LED 灯条为全绿** | 清除命中记录，hit_count 归零 |

> 注意：L2 是发射操作，不会让本机 LED 变红。LED 只有在 VS1838B 收到已注册的**敌方** NEC 帧时才变红；本机和队友的 tankCode 会被忽略。单机调试可在固件中将 `LOCAL_LED_TEST_ON_FIRE` 临时改为 `true`，让每次 L2 发射模拟一次命中，比赛前必须改回 `false`。

### 10.5 VS1838B 激光命中逻辑

| 事件 | 触发条件 | 效果 |
|:----:|---|---|
| **命中** | GPIO 12 收到有效 NEC 帧，地址为 0x42、tankCode 已注册、且该 tankCode 不属于本队，冷却已过（600ms） | 下一颗 LED 变红（从索引 0 到 9 逐个点亮） |
| **重置** | R2 按下 | 所有 LED 恢复绿色，命中计数清零 |
| **上电** | 初始化时 | 所有 LED 初始化为绿色 |
---

## 十一、电机控制真值表

> **定义**：
> - 电机 A = 左电机（接 AO1/AO2，由 AIN1/AIN2/PWMA 控制）
> - 电机 B = 右电机（接 BO1/BO2，由 BIN1/BIN2/PWMB 控制）
> - **STBY（GPIO 10）必须 HIGH 电机才能工作**；置 LOW 可紧急切断双路电机
> - PWM：255 = 全速，200 = 约 78% 速度，0 = 停止

| 动作 | 左电机（A） | AIN1 | AIN2 | PWMA | 右电机（B） | BIN1 | BIN2 | PWMB |
|:----:|:---:|:----:|:----:|:----:|:---:|:----:|:----:|:----:|
| **前进** | 正转 | HIGH | LOW | 255 | 正转 | HIGH | LOW | 255 |
| **后退** | 反转 | LOW | HIGH | 255 | 反转 | LOW | HIGH | 255 |
| **左前**（左弧线前进）| 停止 | LOW | LOW | 0 | 正转 | HIGH | LOW | 255 |
| **右前**（右弧线前进）| 正转 | HIGH | LOW | 255 | 停止 | LOW | LOW | 0 |
| **左后**（左弧线后退）| 停止 | LOW | LOW | 0 | 反转 | LOW | HIGH | 255 |
| **右后**（右弧线后退）| 反转 | LOW | HIGH | 255 | 停止 | LOW | LOW | 0 |
| **原地左转** | 反转 | LOW | HIGH | 200 | 正转 | HIGH | LOW | 200 |
| **原地右转** | 正转 | HIGH | LOW | 200 | 反转 | LOW | HIGH | 200 |
| **制动停止** | 制动 | HIGH | HIGH | 0 | 制动 | HIGH | HIGH | 0 |
| **滑行停止** | 惰行 | LOW | LOW | 0 | 惰行 | LOW | LOW | 0 |

> **制动停止 vs 滑行停止**：
> - **制动停止（Brake）**：AIN1=HIGH, AIN2=HIGH，TB6612 内部短接电机绕组，产生反向制动力，电机迅速减速停止
> - **滑行停止（Coast）**：AIN1=LOW, AIN2=LOW，电机自由滑行，靠自身阻力缓慢停止

---

## 十二、注意事项

| 序号 | 事项 | 说明 |
|:----:|---|---|
| 1 | **3.3V 供电 YFRobot 2015** | YFRobot 2015 必须接 3.3V（非 5V），否则 DAT 输出 5V 可能损坏 ESP32-S3 GPIO |
| 2 | **DAT 上拉电阻** | DAT（GPIO 18）与 YFRobot VCC（3.3V）之间接 10kΩ 上拉电阻，保证空闲时 DAT 维持高电平 |
| 3 | **共地** | 电池组、D153C、ESP32、YFRobot 2015 的 GND 全部短接至公共汇流点 |
| 4 | **STBY 使能** | STBY 必须接 GPIO 10；代码启动和 PS2 失联时保持 LOW，只有 PWM 初始化成功且 PS2 模拟帧有效后才置 HIGH，不要再把 STBY 直接接 3.3V |
| 5 | **GPIO 禁用范围** | GPIO 26~32 被 Flash 占用，GPIO 35~37 被 PSRAM 占用，**绝对禁止**用作普通 IO |
| 6 | **电机转向校正** | 若实测某电机转向与预期相反，互换该电机的两根输出线（AO1↔AO2 或 BO1↔BO2），无需修改代码 |
| 7 | **PS2 通信频率** | 当前固件软件 SPI 时钟约 50kHz（每位周期约 20µs），每次 9 字节查询约 2ms；运行中允许短暂丢帧，连续 250ms 没有有效帧才触发电机失联保护 |
| 8 | **蓝牙配对** | YFRobot 2015 解码器与手柄需先完成蓝牙配对；解码器上电后按手柄 PS 键进行配对 |
| 9 | **死区调整** | 代码中的死区阈值（96/160）可根据实际摇杆漂移量调整，建议先串口打印 LX/LY 原始值确认中心偏差 |
| 10 | **电池容量** | 两个 12V 电机在 7.4V 下启动电流可达 2~4A，确认 18650 电池持续放电倍率 ≥ 2C |
| 11 | **FastLED 库** | WS2812B 控制需安装 **FastLED ≥ 3.6.0**（Arduino IDE → 工具 → 管理库 → 搜索 `FastLED` 安装） |
| 12 | **WS2812B 数据线电平** | 5V 供电时不能假定所有 WS2812B 都可靠识别 3.3V 高电平；推荐使用 5V 供电的 74AHCT125/74HCT245 电平转换器，GPIO 13 不得接收 5V |
| 13 | **VS1838B 供电** | VS1838B 接 D153C 3.3V（兼容 ESP32 GPIO 12 电平）；若接 5V 则 OUT 为 5V，需电平转换才能接 ESP32 |
| 14 | **激光 TTL 电平** | GPIO 11 只有 3.3V 高电平；必须核对发射器 TTL 输入 VIH。若 3.3V 不能保证高电平，使用 5V 供电的 74AHCT125 等电平转换器 |
| 15 | **激光安全** | 980nm 近红外激光，肉眼不可见但会伤害视网膜，请勿直视发射口，避免对准人眼 |
| 16 | **电机供电** | 电机标称 12V，而本方案电池为 2 节串联约 7.4V；电机将降速、降扭矩，必须实测启动/堵转电流并确认 D153C 和电池/BMS 不过流 |

---

## 十三、固件烧录说明（Arduino IDE）

### 13.1 开发环境要求

| 软件 | 版本要求 | 说明 |
|---|:---:|---|
| **Arduino IDE** | ≥ 2.3 | 推荐使用 IDE 2.x，内置库管理器和串口监视器 |
| **Arduino-ESP32 BSP** | **≥ 3.0**（本固件使用 v3.x API） | 通过 Arduino IDE 的「开发板管理器」安装 |
| **CP210x / CH340 驱动** | 视开发板 USB 芯片而定 | macOS 12+ 需手动安装 CH340 驱动 |
| **FastLED 库** | **≥ 3.6.0** | 工具 → 管理库 → 搜索 `FastLED` 安装（用于 WS2812B 控制） |

> ⚠️ 本固件（`esp32_robot_controller.ino`）使用 **Arduino-ESP32 v3.x** API（`ledcAttach` / `ledcWrite(pin, val)`）。  
> 若使用 v2.x BSP 编译将报错，请在「开发板管理器」确认版本 ≥ 3.0。

### 13.2 安装 Arduino-ESP32 BSP（v3.x）

1. 打开 Arduino IDE → **文件 → 首选项**
2. 在「附加开发板管理器网址」中添加：
   ```
   https://espressif.github.io/arduino-esp32/package_esp32_index.json
   ```
3. 打开 **工具 → 开发板 → 开发板管理器**，搜索 `esp32`
4. 选择 **esp32 by Espressif Systems**，安装 **3.x.x 最新版本**

### 13.3 Arduino IDE 烧录参数配置

打开 `esp32_robot_controller.ino` 后，按下表配置 **工具** 菜单各项：

| 工具菜单项 | 推荐设置 | 说明 |
|---|:---:|---|
| **开发板** | `ESP32S3 Dev Module` | 在 esp32 → ESP32S3 Dev Module |
| **USB CDC On Boot** | `Disabled` | 避免占用 USB 串口影响调试（不使用 USB CDC 输出） |
| **CPU Frequency** | `240MHz (WiFi)` | 最高性能，PS2 软件 SPI 时序更稳定 |
| **Flash Mode** | `QIO 80MHz` | N8R2 8MB Flash 标准模式 |
| **Flash Size** | `8MB (64Mb)` | 对应 N8R2 的 8MB Flash |
| **Partition Scheme** | `8M with spiffs (3MB APP/1.5MB SPIFFS)` | 保证 APP 分区足够大 |
| **PSRAM** | `OPI PSRAM` | N8R2 内置 2MB OPI PSRAM（R2） |
| **Upload Speed** | `921600` | 高速烧录，若失败降为 `460800` |
| **端口** | 对应 USB 串口 | macOS 通常为 `/dev/tty.usbserial-xxxx` 或 `/dev/tty.SLAB_USBtoUART` |

### 13.4 烧录步骤

```
① 用 USB-C 数据线连接 ESP32-S3 N8R2 与电脑
         （确认线材支持数据传输，仅充电线无法识别串口）
② Arduino IDE 选择上述开发板和端口参数
③ 点击「上传（→）」按钮，等待编译完成
④ 若烧录卡在「Connecting...」：
     · 按住 ESP32-S3 板上的 BOOT 按钮
     · 同时短按 RST 按钮后松开
     · 再松开 BOOT 按钮  → 进入下载模式
⑤ 烧录完成后，串口监视器（115200 baud）应显示：
     ========================================
      ESP32-S3 Robot Controller  v2.0
      YFRobot 2015 + TB6612 D153C
      Laser TX/RX + WS2812B LED
     ========================================
        [TB6612] STBY=LOW, PWM 20kHz 8-bit OK
        [Laser]  TX=GPIO11, NEC address=0x42, tankCode=0x01  OK
     [LaserRX] RX=GPIO12, INPUT_PULLUP  OK
      [LED]    WS2812B x10, GPIO13, brightness=60  OK
     [PS2]   Waiting for YFRobot 2015 decoder......  OK
     [PS2]   Analog mode confirmed (ID=0x73)
     [Ready] Left joystick → motor control
     L2 short/long press = laser  R2 = reset LEDs
```

### 13.5 常见烧录问题排查

| 现象 | 原因 | 解决方法 |
|---|---|---|
| 端口不显示 | 未安装 USB 转串口驱动 | macOS：安装 CH340 驱动（WCH 官网）或 CP210x 驱动（Silicon Labs） |
| `Connecting...` 超时 | 未进入下载模式 | 按步骤④手动触发 BOOT+RST |
| `ledcAttach was not declared` | BSP 版本为 v2.x | 在开发板管理器升级 esp32 BSP 到 ≥ 3.0 |
| 编译通过但电机不动 | STBY 未拉高 / 接线错误 | 用万用表确认 GPIO 10 高电平；检查 AIN1/AIN2/BIN1/BIN2 接线 |
| PS2 一直 `TIMEOUT` 或运行中频繁出现 `Invalid frame` | DAT 无上拉、供电掉压、共地不良、蓝牙未配对或通信线受电机干扰 | 确认 DAT↔VCC 之间有 10kΩ；确认 YFRobot 2015 接稳定的 3.3V；所有模块共地；先断开电机测试；缩短 CLK/CMD/DAT/CS 线并远离电机线；查看串口打印的 9 字节原始帧 |
| 电机偶发停顿但之后自动恢复 | PS2 瞬时丢帧 | 当前固件会容忍短暂丢帧；若连续 250ms 无有效帧才关闭 STBY。若仍频繁停顿，优先检查 YFRobot 供电、DAT 上拉和电机启动造成的电源压降 |

### 13.6 IRremote

在 Arduino IDE 里安装 IRremote 4.6+，直接编译这份草图。当前固件发送的是一帧 38kHz NEC 数据，不是持续 200ms 的激光载波；长按时每 300ms 发送一帧。
激光发射器清单标注为 100kHz TTL，而 VS1838B 需要 38kHz 载波。必须确认该发射器的 TTL 输入能够接受 38kHz 门控信号；若它只支持固定 100kHz 调制，当前 NEC 方案不能直接使用。
先用两台车验证 tankCode 映射和敌我过滤，再决定是否补更多坦克到本地映射表。
如果 ESP32-S3 上 IRremote 有兼容性问题，我可以继续帮你改成 TinyIR 或 IRremoteESP8266 版本。

现在的结构是：

增加了 IRremote 依赖、tankCode 和本地映射表，tankCode -> tankid 的映射定义在 esp32_robot_controller.ino:79 和 esp32_robot_controller.ino:82。
发射时不再发送自定义字符串脉冲帧，而是直接用 `IrSender.sendNEC(LASER_IR_ADDRESS, tankCode, 0)` 发一个 NEC 帧。
接收时改成 `IrReceiver.decode()` 读取 NEC 帧，把收到的 command 当作 tankCode，再本地映射回 tankid 并用 teamtankids 判断敌我。
setup() 里使用 `IrSender.begin(...)` / `IrReceiver.begin(...)`，电机只有在 PS2 模拟帧有效且 PWM 初始化成功后才释放 STBY。
