barrymulinwqn/ESP32-robot-competition/Arduino/joystick_bluetooth/ESP32/3DPrinter/ender3_s1_plus_pla_slicing_profile.md

# Ender-3 S1 Plus PLA 切片参数

适用对象：
- 打印机：Creality Ender-3 S1 Plus
- 材料：PLA
- 模型类型：`hollow_rect_100_80_80.stl`
- 模型特征：100 x 80 x 80 mm，中空，壁厚 2 mm，底部敞口

## 推荐起始参数

### 机器与材料
- 喷嘴直径：0.4 mm
- 材料：PLA
- 打印模式：常规质量模式

### 温度
- 喷嘴温度：205 C
- 热床温度：60 C
- 首层喷嘴温度：210 C
- 首层热床温度：60 C

### 层高
- 层高：0.20 mm
- 首层层高：0.24 mm

### 线宽
- 默认线宽：0.40 mm
- 外壁线宽：0.40 mm
- 内壁线宽：0.40 mm
- 顶面线宽：0.40 mm

### 壁与顶面
- 壁线数：5
- 壁厚：2.0 mm
- 顶层数：5
- 顶部厚度：1.0 mm
- 底层数：0
- 底部厚度：0 mm

说明：
该模型本身就是底部敞口结构，`底层数` 设为 `0` 可避免切片器错误地把底面封住。

### 填充
- 填充密度：0%
- 填充图案：无

说明：
这是一个薄壁中空盒体，主要依靠外壁成形，不需要额外填充。

### 速度
- 打印速度：50 mm/s
- 外壁速度：30 mm/s
- 内壁速度：40 mm/s
- 顶面速度：25 mm/s
- 首层速度：20 mm/s
- 移动速度：120 mm/s

### 回抽
- 回抽开启：是
- 回抽距离：0.8 mm
- 回抽速度：40 mm/s
- 梳理模式：在填充内或不穿越外壁
- Z Hop：0.2 mm

说明：
Ender-3 S1 Plus 原厂 Sprite 直驱挤出机打印 PLA 时，`0.8 mm` 回抽通常是安全起点。

### 风扇
- 模型风扇：开启
- 首层风扇：0%
- 第 2 层风扇：50%
- 第 3 层及以后：100%

### 粘附
- 平台附着：Brim
- Brim 宽度：6 mm
- Brim 线数：10 到 12

说明：
这个模型底部接触平台的是一圈 2 mm 厚边框，虽然接地面积不算太小，但为了降低翘边风险，建议使用 `Brim`。

### 支撑
- 支撑：关闭

说明：
该模型开口朝下放置时无需支撑。

## 模型摆放建议
- 开口朝下放在热床上
- 长边沿 X 或 Y 方向均可
- 如果出现前后方向轻微翘边，可将模型旋转 90 度后再试

## 如果打印效果不好，按这个顺序调整

### 如果层间结合偏弱
- 喷嘴温度提高到 210 C
- 风扇最大值降到 80%
- 打印速度降到 45 mm/s

### 如果拉丝明显
- 喷嘴温度降到 200 C
- 回抽距离增大到 1.0 mm
- 回抽速度提高到 45 mm/s

### 如果底边翘起
- 热床温度提高到 65 C
- Brim 宽度增加到 8 mm
- 首层速度降到 15 mm/s
- 清洁热床并重新调平

### 如果尺寸偏小或孔隙感明显
- 检查实际挤出流量
- 墙厚优先保持 2.0 mm
- 必要时把线宽改为 0.42 mm，并重新观察壁面闭合情况

## 最稳妥的一套参数
如果你只想先快速成功打一件，优先用下面这组：

- 喷嘴：205 C
- 热床：60 C
- 层高：0.20 mm
- 壁线数：5
- 顶层数：5
- 填充：0%
- 打印速度：50 mm/s
- 外壁速度：30 mm/s
- 回抽：0.8 mm @ 40 mm/s
- 风扇：第 3 层后 100%
- 支撑：关闭
- 平台附着：Brim 6 mm

## 备注
不同品牌 PLA 最佳温度会有差异。若你使用高速 PLA、哑光 PLA 或丝绸 PLA，需要单独微调温度和风扇参数。
