barrymulinwqn/ESP32-robot-competition/Arduino/joystick_bluetooth/2_Motor_16_Servo_Drive_Board.jpg

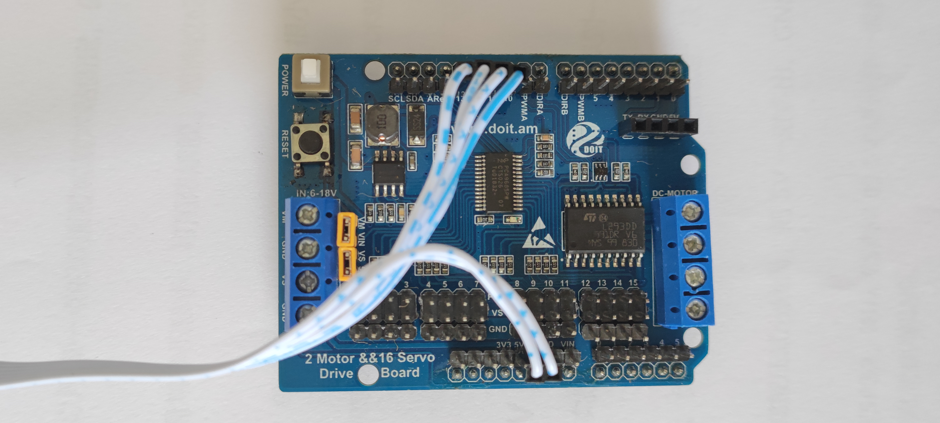
Arduino/joystick_bluetooth/2_Motor_16_Servo_Drive_Board.jpg
