barrymulinwqn/ESP32-robot-competition/Arduino/joystick_bluetooth/Digital_PWM_UNO.jpg

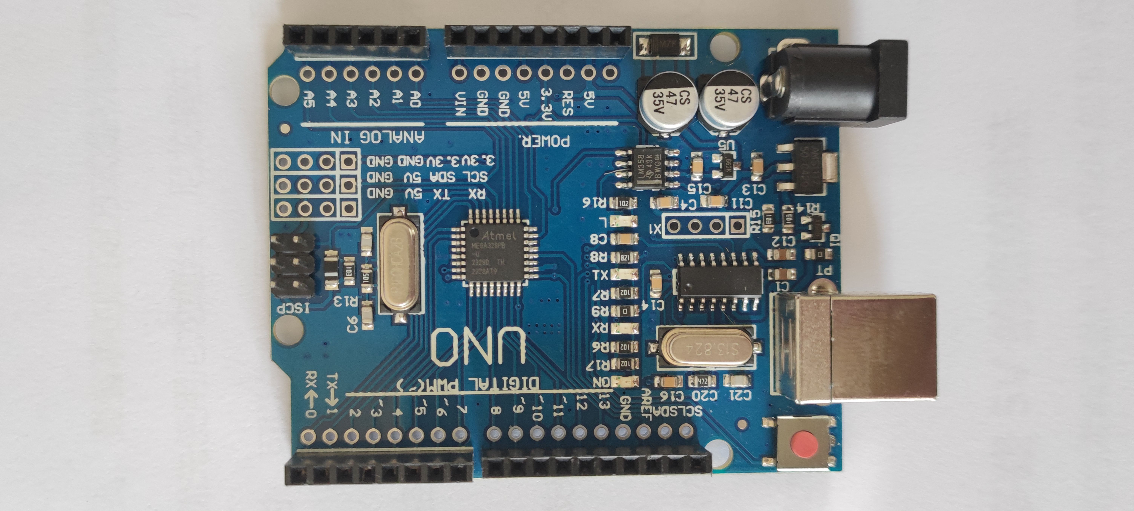
Arduino/joystick_bluetooth/Digital_PWM_UNO.jpg
