barrymulinwqn/ESP32-robot-competition/Arduino/joystick_bluetooth/joystick.jpg

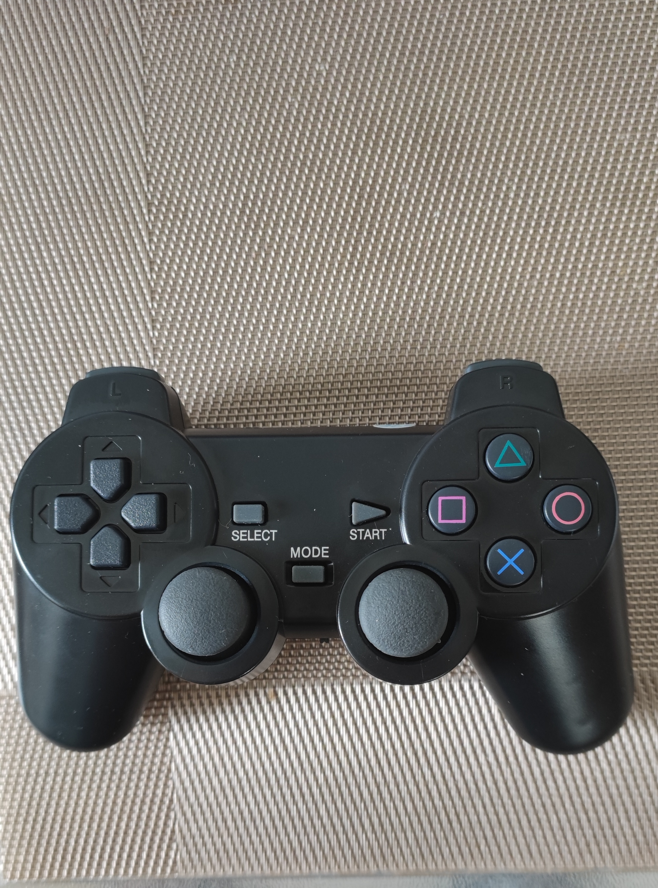
Arduino/joystick_bluetooth/joystick.jpg
