barrymulinwqn/ESP32-robot-competition/Arduino/joystick_bluetooth/uno_final.jpg

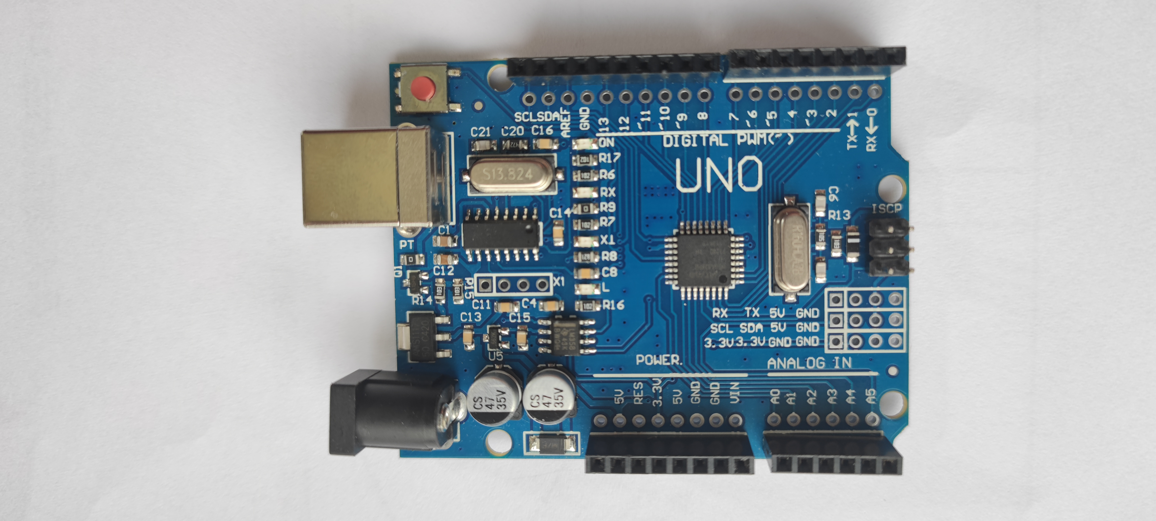
Arduino/joystick_bluetooth/uno_final.jpg
