barrymulinwqn/ESP32-robot-competition/Arduino/joystick_bluetooth/Weixin Image_20260505180024_90_2.jpg

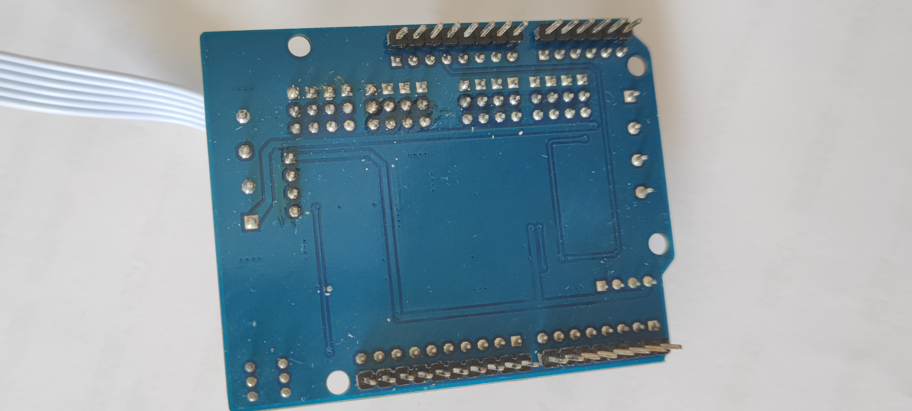
Arduino/joystick_bluetooth/Weixin Image_20260505180024_90_2.jpg
