barrymulinwqn/ESP32-robot-competition/ori_models/penholder.jpg

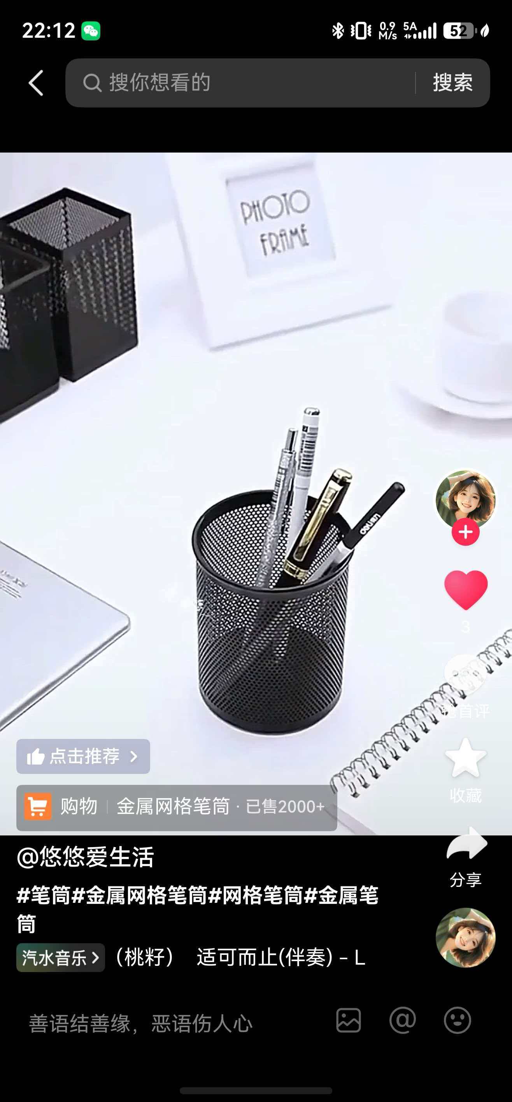
ori_models/penholder.jpg
