barrymulinwqn/ESP32-robot-competition/Arduino/joystick_bluetooth/ESP32/3DPrinter/hollow_cylinder_open_bottom_20od_18id_15h_top_hole_2mm.stl

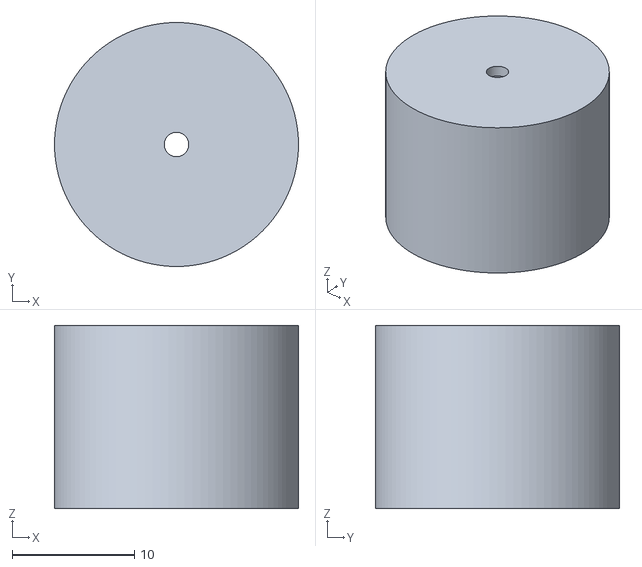
[picture p10: CAD file, 2026-06-19]
Arduino/joystick_bluetooth/ESP32/3DPrinter/hollow_cylinder_open_bottom_20od_18id_15h_top_hole_2mm.stl
20.0 x 20.0 x 15.0
