barrymulinwqn/ESP32-robot-competition/Arduino/joystick_bluetooth/ESP32/bk/hollow_rectangular_box_100x80x80mm_open_bottom.3mf

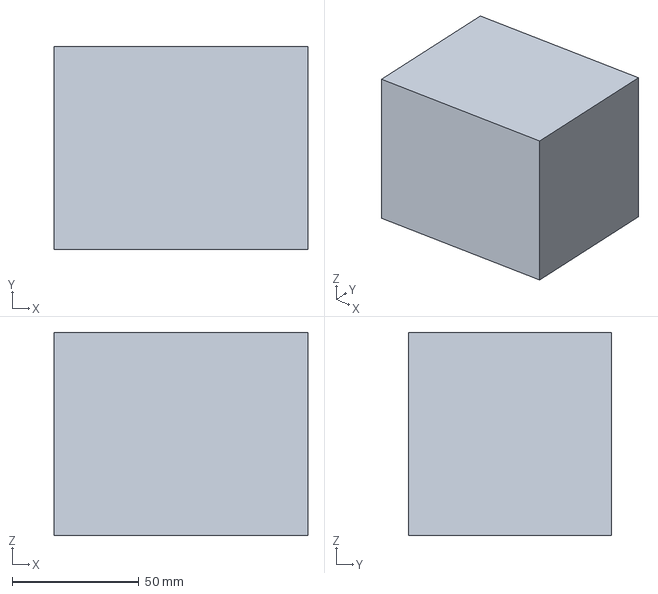
[picture p11: CAD file, 2026-06-19]
Arduino/joystick_bluetooth/ESP32/bk/hollow_rectangular_box_100x80x80mm_open_bottom.3mf
100.0 x 80.0 x 80.0 mm
