barrymulinwqn/ESP32-robot-competition/new_RA_logo/bus_custom_0709.3mf

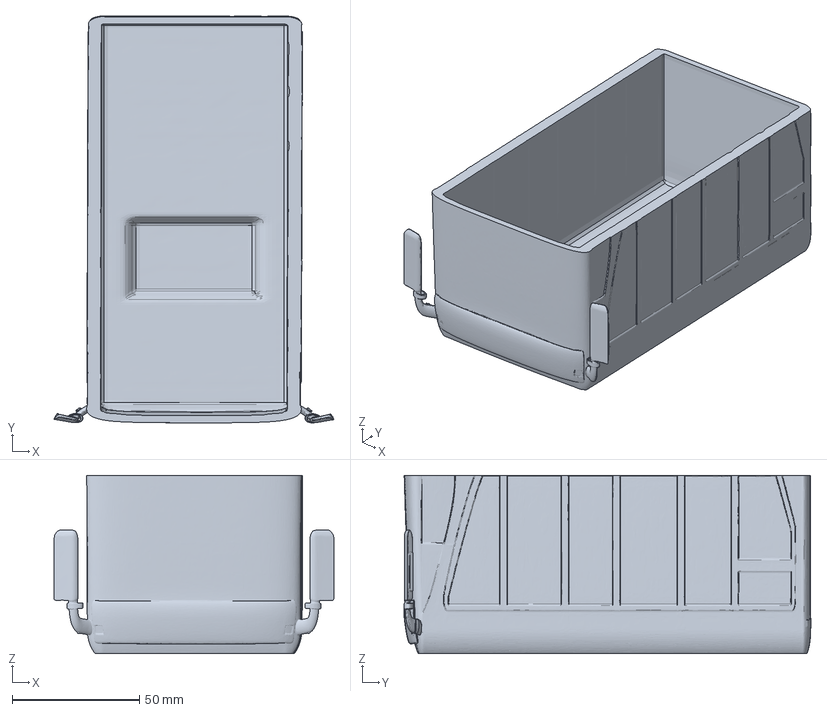
[picture p12: CAD file, 2026-07-08]
new_RA_logo/bus_custom_0709.3mf
110.0 x 160.0 x 70.0 mm
