barrymulinwqn/ESP32-robot-competition/ori_models/bus_0709_bk.3mf

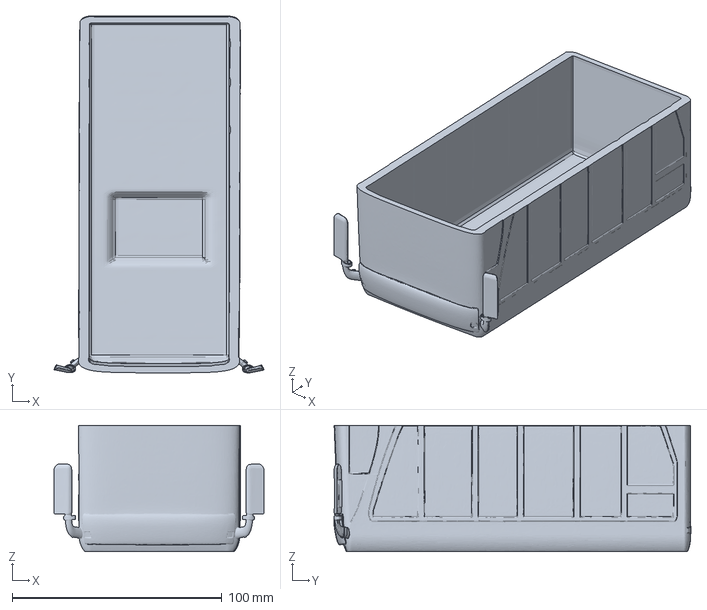
[picture p13: CAD file, 2026-07-08]
ori_models/bus_0709_bk.3mf
100.0 x 170.0 x 60.0 mm
