barrymulinwqn/ESP32-robot-competition/PenHolder/kulinanF.3mf

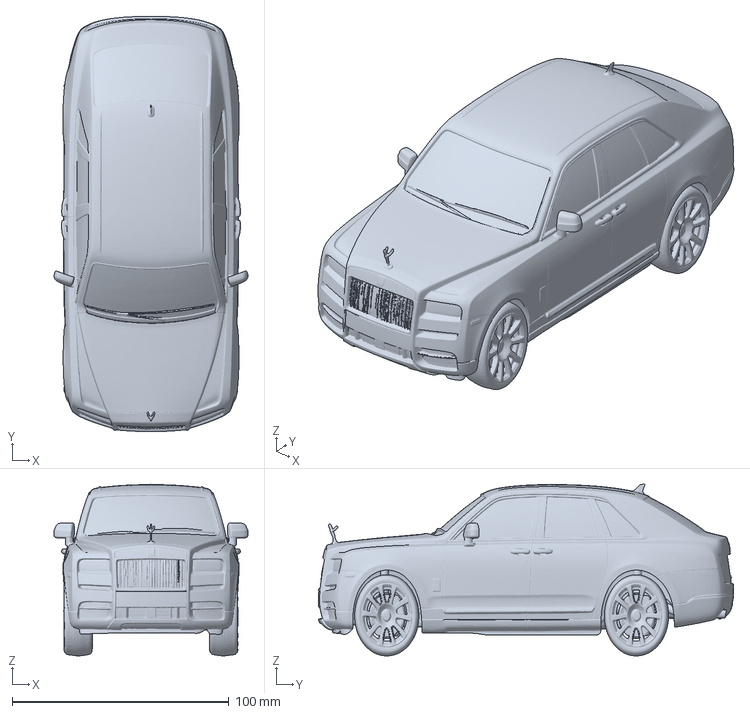
[picture p14: CAD file, 2026-06-27]
PenHolder/kulinanF.3mf
89.5 x 191.8 x 79.3 mm
