barrymulinwqn/ESP32-robot-competition/Arduino/joystick_bluetooth/ESP32/Final_Creality/hollow_rect_100_80_80.stl

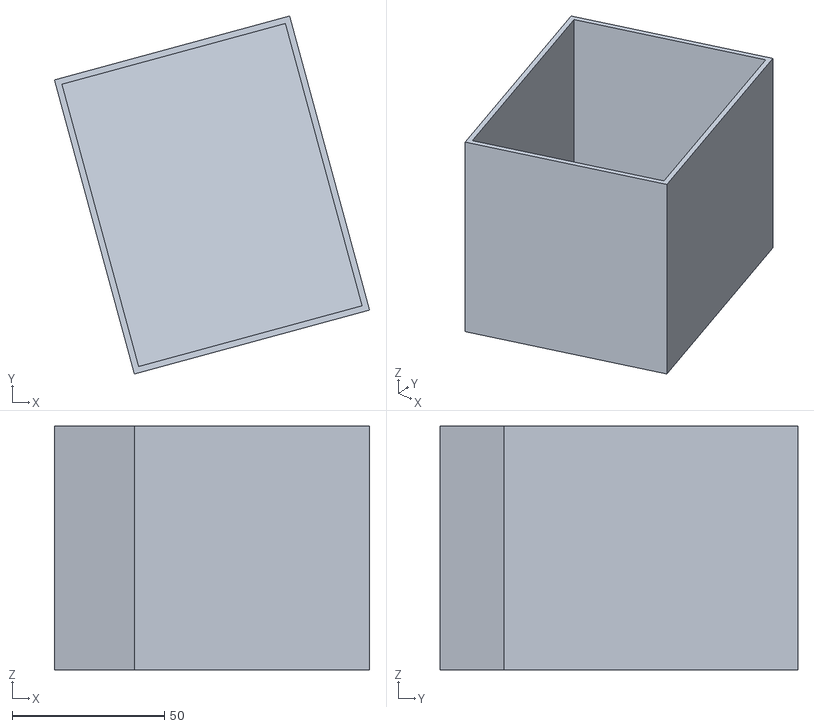
[picture p15: CAD file, 2026-06-19]
Arduino/joystick_bluetooth/ESP32/Final_Creality/hollow_rect_100_80_80.stl
103.4 x 117.5 x 80.0
