barrymulinwqn/ESP32-robot-competition/new_RA_logo/hollow_rectangular_box_100x80x80mm_open_bottom.3mf

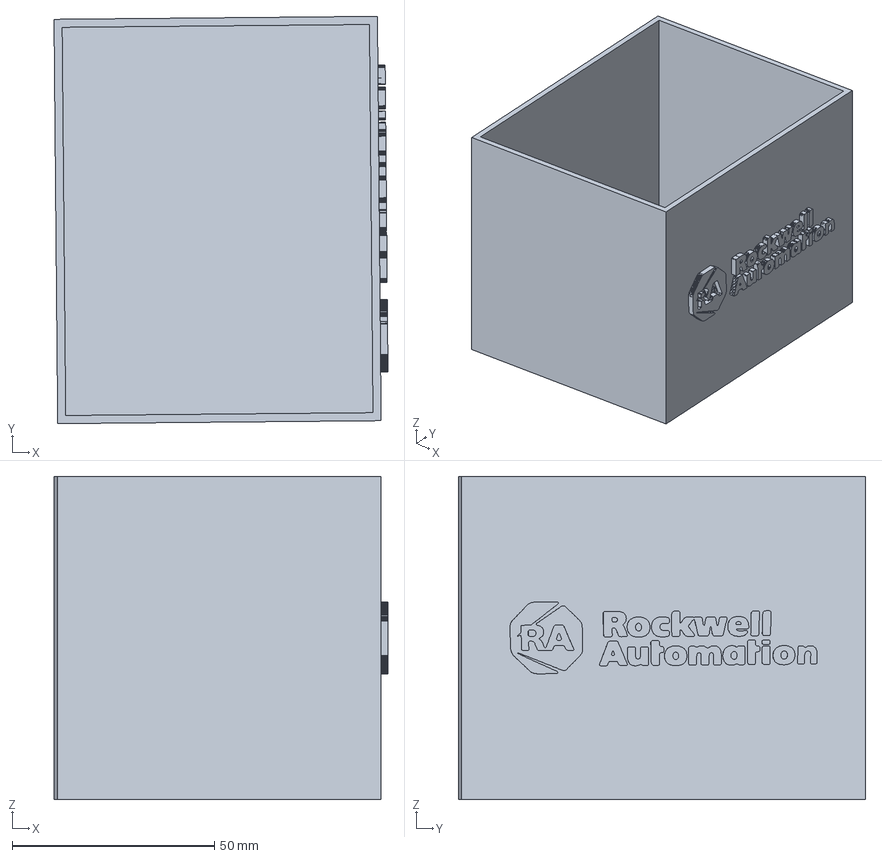
[picture p16: CAD file, 2026-07-05]
new_RA_logo/hollow_rectangular_box_100x80x80mm_open_bottom.3mf
82.6 x 100.7 x 80.0 mm
