barrymulinwqn/ESP32-robot-competition/ori_models/黑色方形容器.3mf

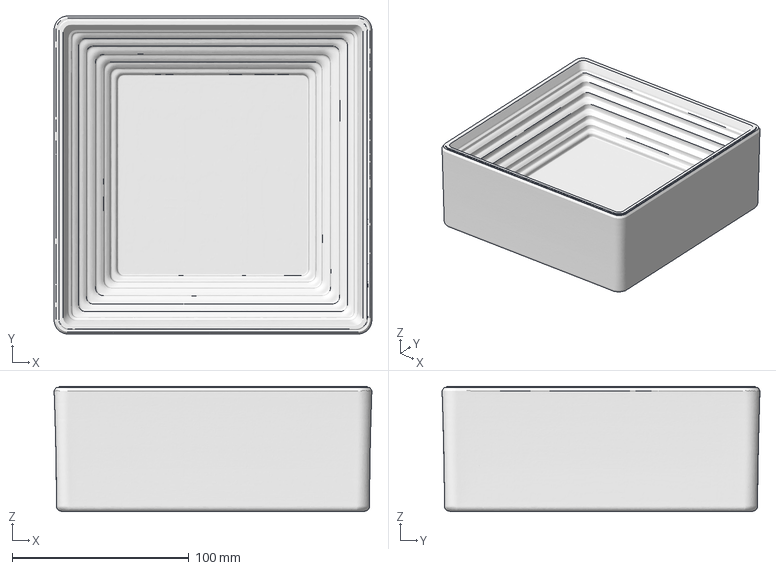
[picture p17: CAD file, 2026-07-05]
ori_models/黑色方形容器.3mf
179.9 x 180.0 x 71.0 mm
