barrymulinwqn/ESP32-robot-competition/PenHolder/库里南.3mf

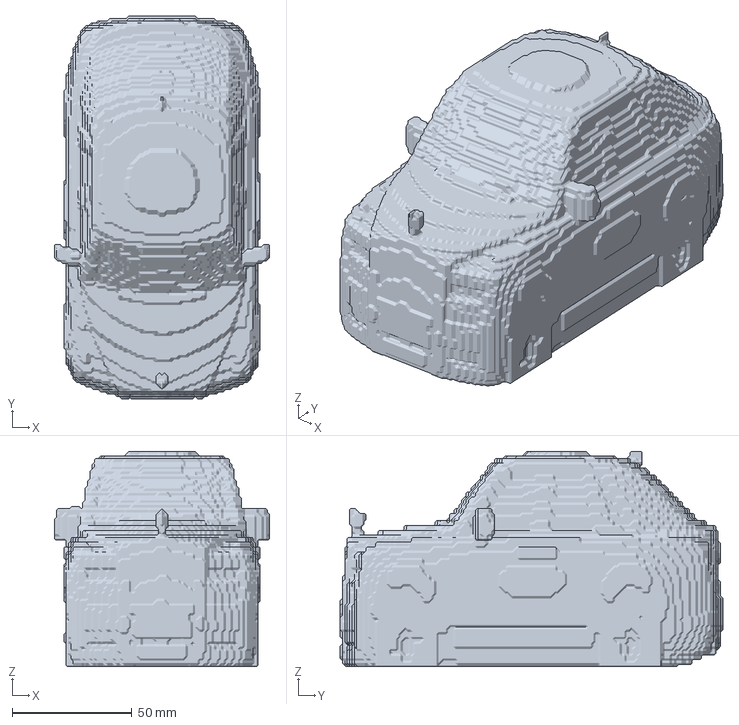
[picture p18: CAD file, 2026-06-27]
PenHolder/库里南.3mf
90.0 x 160.0 x 90.0 mm
