barrymulinwqn/ESP32-robot-competition/new_RA_logo/pen_holder_ra2026_100od_120h_3p5wall.3mf

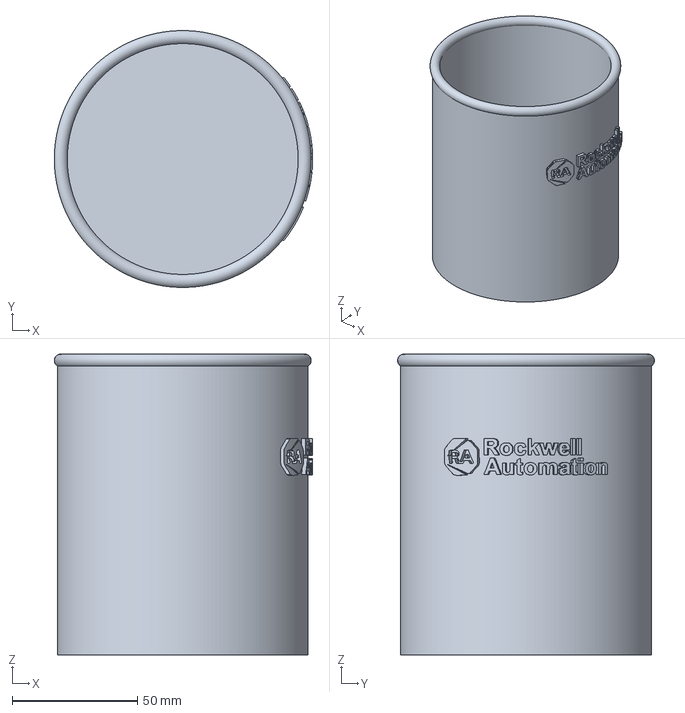
[picture p19: CAD file, 2026-07-05]
new_RA_logo/pen_holder_ra2026_100od_120h_3p5wall.3mf
103.0 x 102.4 x 120.0 mm
