barrymulinwqn/ESP32-robot-competition/ori_models/路易威登Monogram镂空烛台.3mf

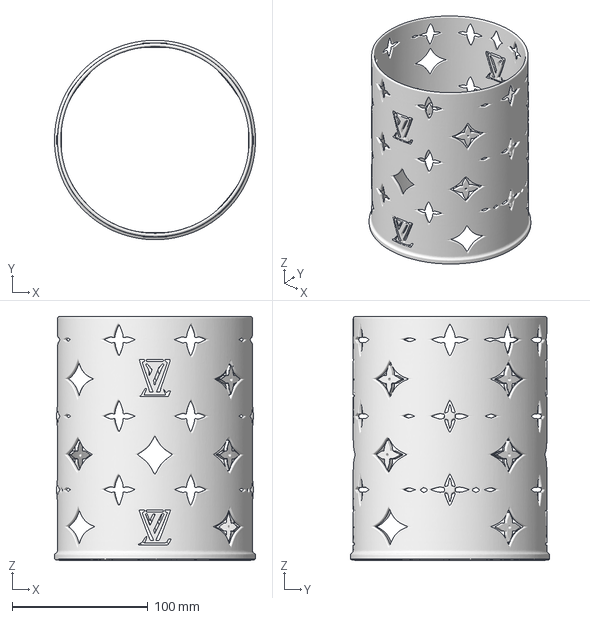
[picture p20: CAD file, 2026-07-05]
ori_models/路易威登Monogram镂空烛台.3mf
148.3 x 147.1 x 180.0 mm
