barrymulinwqn/ESP32-robot-competition/PenHolder/pen_holder_ra2026_rockwell_automation_100od_120h_3p5wall.3mf

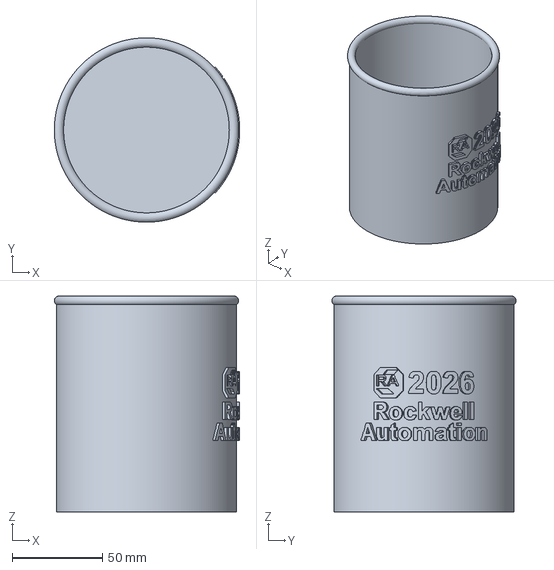
[picture p21: CAD file, 2026-06-26]
PenHolder/pen_holder_ra2026_rockwell_automation_100od_120h_3p5wall.3mf
103.0 x 102.4 x 120.0 mm
