barrymulinwqn/ESP32-robot-competition/ori_models/库里南.3mf

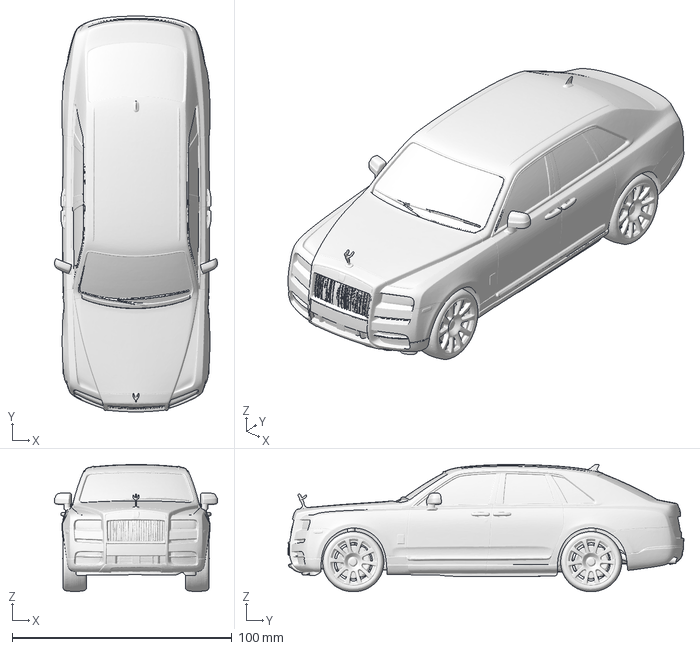
[picture p22: CAD file, 2026-06-26]
ori_models/库里南.3mf
74.1 x 180.0 x 58.0 mm
