barrymulinwqn/ESP32-robot-competition/ori_models/镭射幻彩熊公仔.3mf

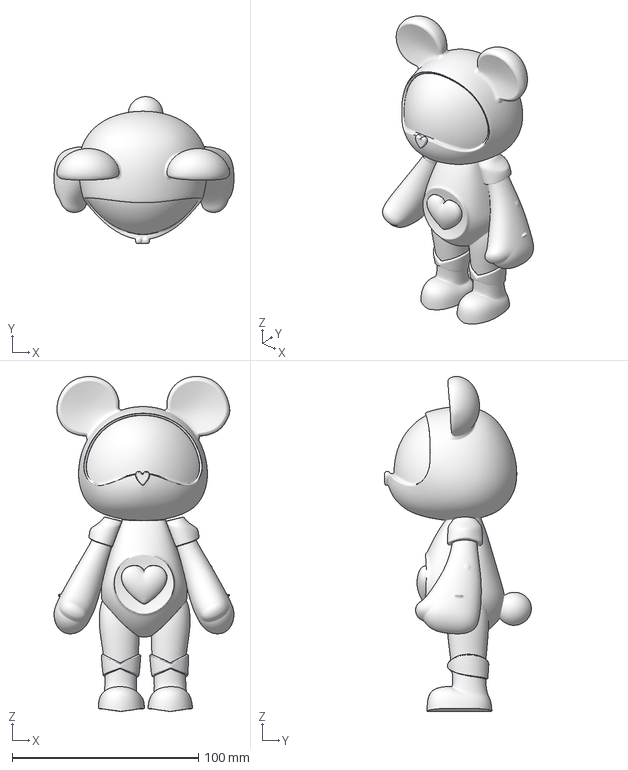
[picture p23: CAD file, 2026-06-26]
ori_models/镭射幻彩熊公仔.3mf
96.7 x 78.9 x 180.0 mm
