barrymulinwqn/ESP32-robot-competition/ori_models/比萨斜塔.3mf

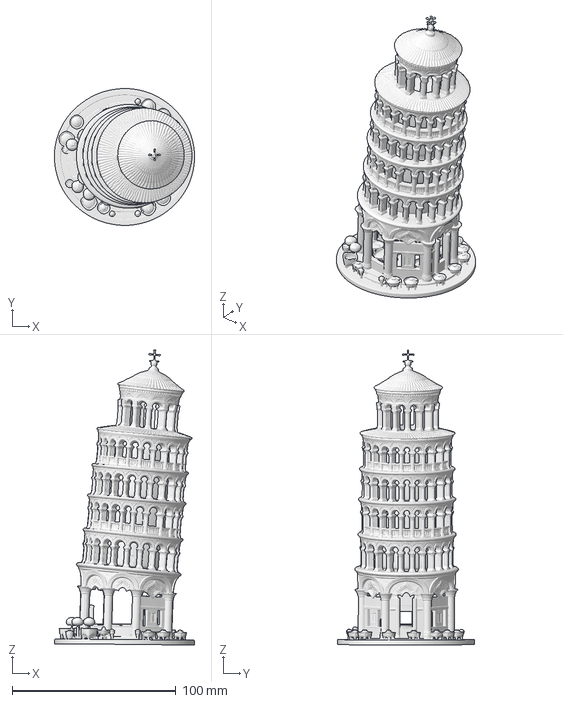
[picture p24: CAD file, 2026-06-26]
ori_models/比萨斜塔.3mf
85.5 x 83.6 x 180.0 mm
