barrymulinwqn/ESP32-robot-competition/ori_models/奔跑的哆啦A梦.3mf

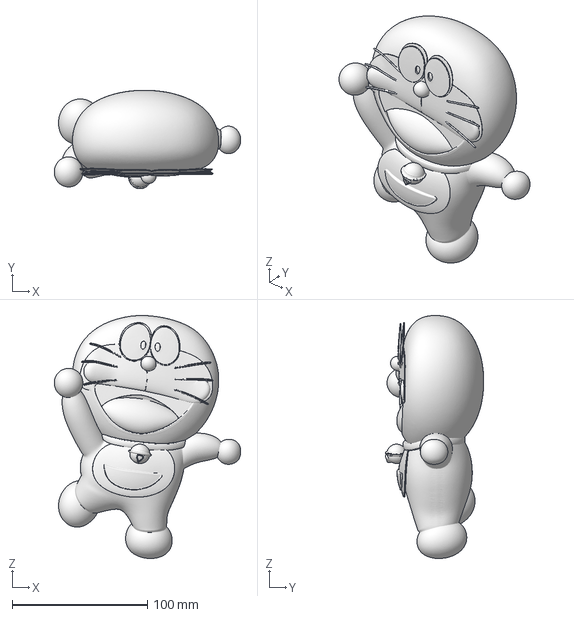
[picture p25: CAD file, 2026-06-26]
ori_models/奔跑的哆啦A梦.3mf
138.1 x 72.9 x 180.0 mm
