barrymulinwqn/ESP32-robot-competition/ori_models/falali2.3mf

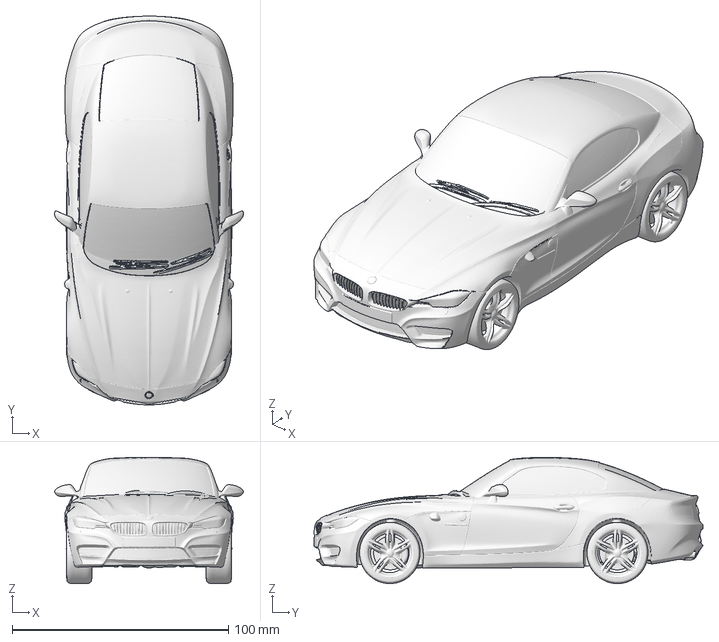
[picture p26: CAD file, 2026-06-26]
ori_models/falali2.3mf
87.5 x 180.0 x 58.4 mm
