barrymulinwqn/ESP32-robot-competition/ori_models/3D巴士模型(1).3mf

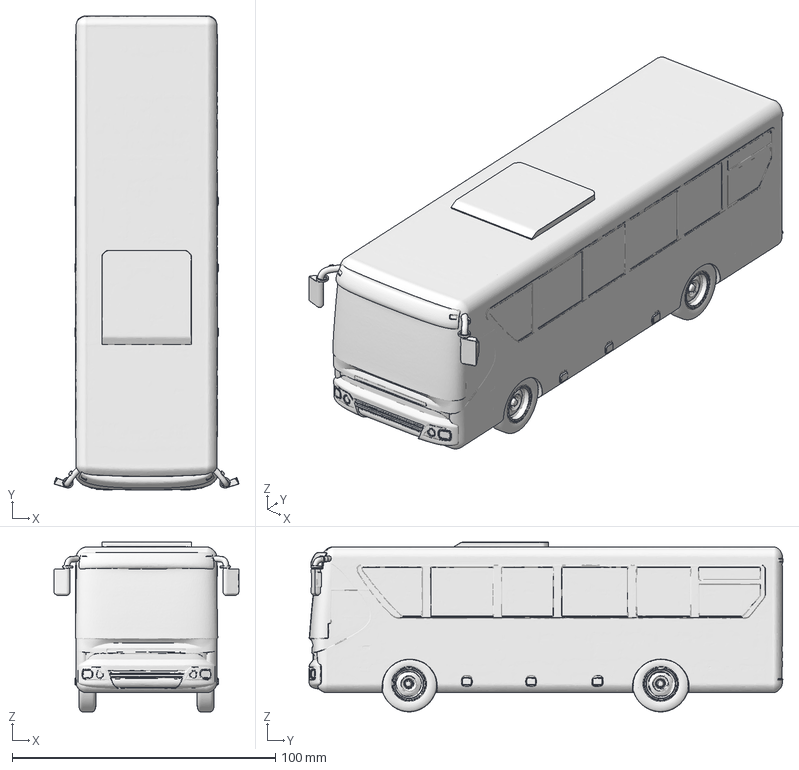
[picture p27: CAD file, 2026-06-26]
ori_models/3D巴士模型(1).3mf
70.1 x 180.0 x 64.5 mm
