barrymulinwqn/ESP32-robot-competition/ori_models/劳斯莱斯汽车正面(1).3mf

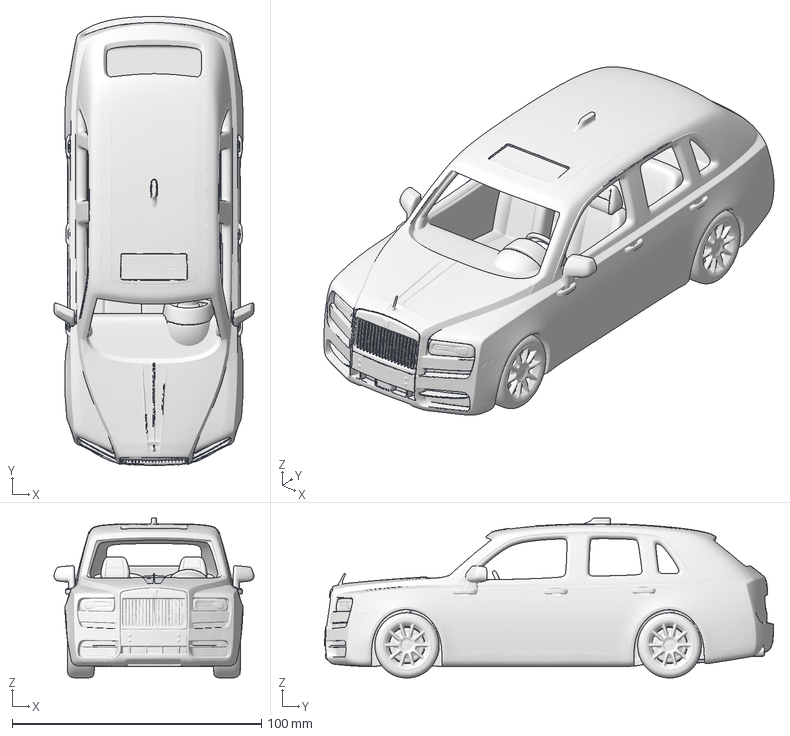
[picture p28: CAD file, 2026-06-26]
ori_models/劳斯莱斯汽车正面(1).3mf
80.1 x 180.0 x 64.1 mm
