barrymulinwqn/ESP32-robot-competition/ori_models/falali.3mf

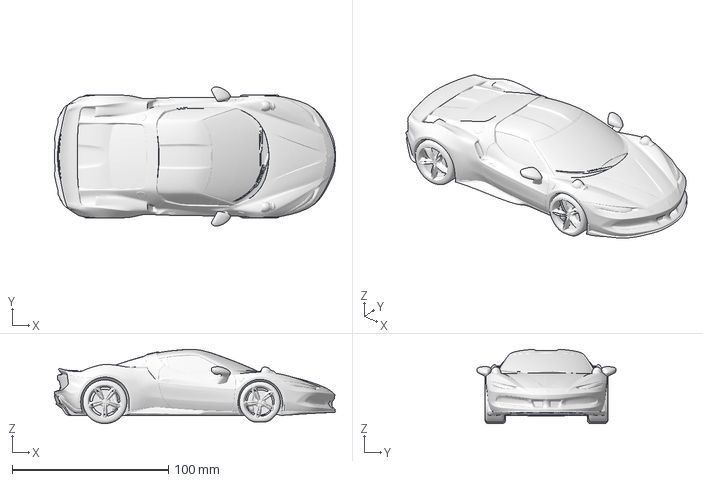
[picture p29: CAD file, 2026-06-26]
ori_models/falali.3mf
180.0 x 89.2 x 47.6 mm
