barrymulinwqn/ESP32-robot-competition/ori_models/champion.3mf

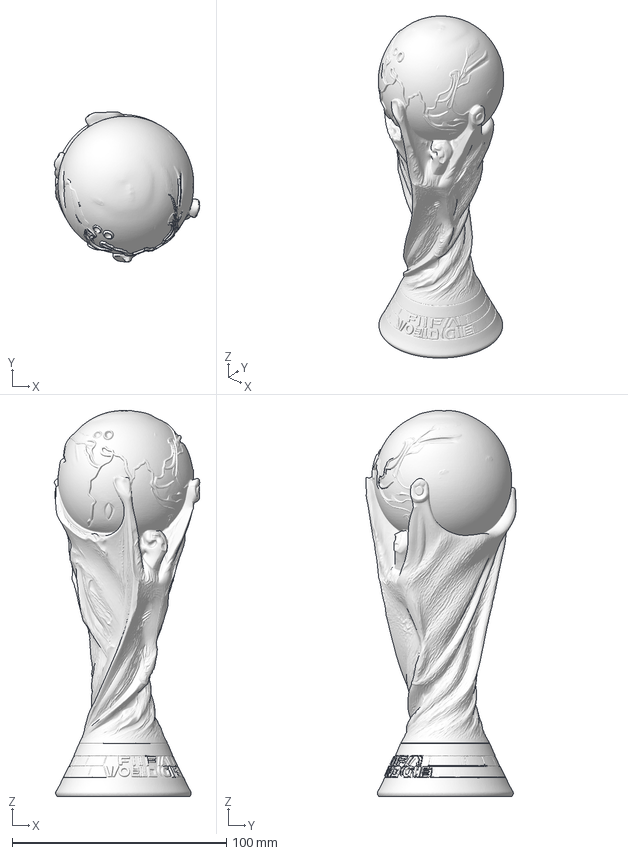
[picture p30: CAD file, 2026-06-26]
ori_models/champion.3mf
67.9 x 70.1 x 180.0 mm
