barrymulinwqn/ESP32-robot-competition/(list of files, cad)

Other CAD files:
Arduino/joystick_bluetooth/ESP32/Final_Creality/hollow_cylinder.stl
Arduino/joystick_bluetooth/ESP32/FreeCAD/hollow_cylinder_open_bottom_20od_18id_15h_top_hole_2mm.3mf
Arduino/joystick_bluetooth/ESP32/3DPrinter/hollow_rect_100_80_80.stl
new_RA_logo/pen_holder_ra2026_rockwell_automation_100od_120h_3p5wall.3mf
PenHolder/pen_holder_ra2026_100od_120h_3p5wall.3mf
PenHolder/pen_holder_ra2026_100od_120h_3p5wall.stl
