barrymulinwqn/ESP32-robot-competition/(commit log)

2026-04-12 esp32 s3 pins latest info
2026-04-19 esp32 s3 default gateway
2026-05-24 esp32 and joystick combination
2026-05-24 laser on and feedback
2026-05-24 robotic arm file
2026-06-19 3d printer
    [hollow_rect_100_80_80.stl, hollow_rectangular_box_100x80x80mm_open_bottom.3mf]
2026-06-19 gcode file
    [hollow_cylinder.stl, hollow_cylinder_open_bottom_20od_18id_15h_top_hole_2mm.3mf, hollow_cylinder_open_bottom_20od_18id_15h_top_hole_2mm.stl]
2026-06-19 custom data transition for laser on
2026-06-19 custom data for IRremote case
2026-06-25 penholder 3d printer
    [pen_holder_ra2026_100od_120h_3p5wall.3mf]
2026-06-26 new smf files
    [3D巴士模型(1).3mf, champion.3mf, falali.3mf, falali2.3mf, 劳斯莱斯汽车正面(1).3mf, 奔跑的哆啦A梦.3mf, 比萨斜塔.3mf, 镭射幻彩熊公仔.3mf]
2026-06-26 penholder 3mf
    [pen_holder_ra2026_100od_120h_3p5wall.3mf]
2026-06-26 penholder g-code file
    [pen_holder_ra2026_rockwell_automation_100od_120h_3p5wall.3mf, 库里南.3mf]
2026-06-27 kulinan update
    [kulinanF.3mf, 库里南.3mf]
2026-07-05 new 3d slicer files
    [hollow_rectangular_box_100x80x80mm_open_bottom.3mf, pen_holder_ra2026_100od_120h_3p5wall.3mf, pen_holder_ra2026_rockwell_automation_100od_120h_3p5wall.3mf]
2026-07-05 new slicer files
    [路易威登Monogram镂空烛台.3mf, 黑色方形容器.3mf]
2026-07-05 new slicer files for new logo
    [pen_holder_ra2026_100od_120h_3p5wall.3mf]
2026-07-05 new gcode files
    [hollow_rectangular_box_100x80x80mm_open_bottom.3mf]
2026-07-08 new penholder 3mf files
    [bus_0709_bk.3mf, bus_custom_0709.3mf]
2026-07-25 joystick and esp32 real game match case
